UNR-Aerospace-Club/T.A.C.O.S/README.md

# T.A.C.O.S
Typical Avionics Control and Operations System

The hardware and software needed for a custom hat-based modular rocket avionics system
