UNR-Aerospace-Club/T.A.C.O.S/cad/Rack.FCStd

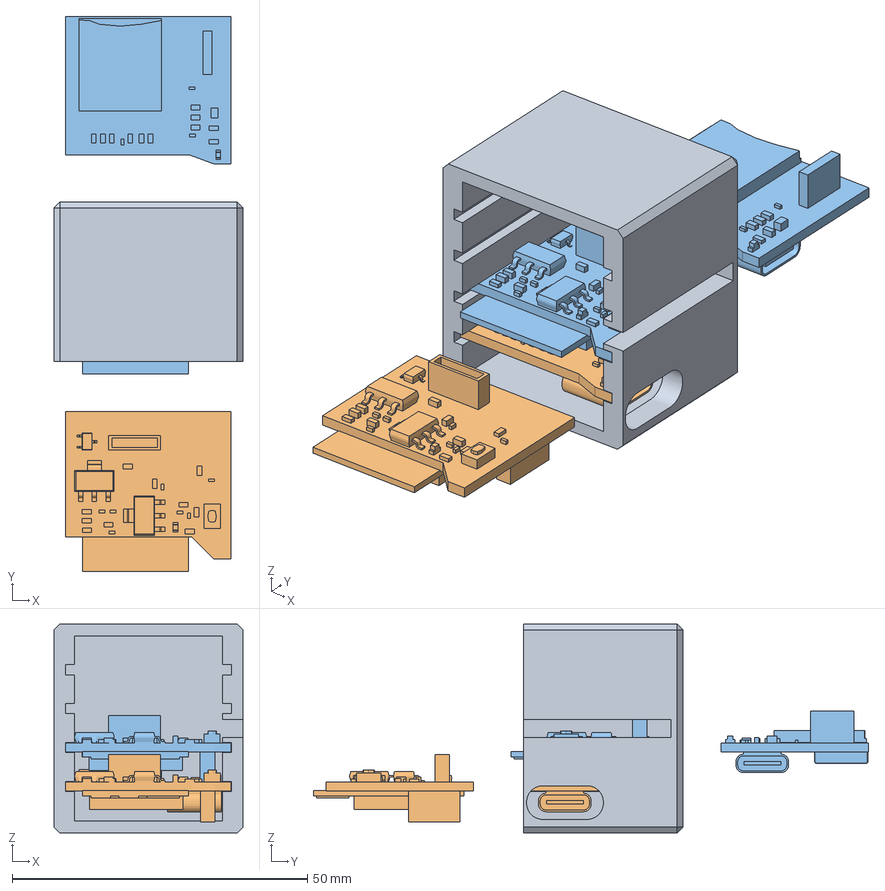
[picture p1: CAD file, 2025-10-07]
cad/Rack.FCStd
32.0 x 94.0 x 35.4 mm
Rack
MainBoardRemesh
MainBoardRemesh001
