UNR-Aerospace-Club/T.A.C.O.S/hardware/DummyHat/DummyHat.kicad_pcb

## KiCad design hardware/DummyHat/DummyHat.kicad_pcb (2025-11-24)

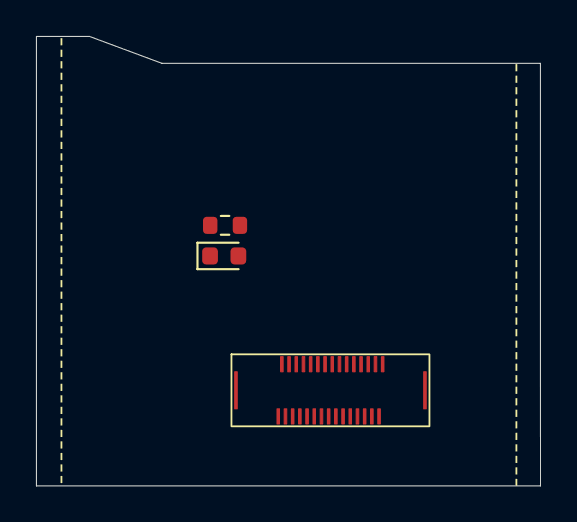
[picture p2: board hardware/DummyHat/DummyHat.kicad_pcb from above]

Board: 2 copper layers, 28.0 x 25.0 mm, 4 parts (1 on the bottom side), 33 nets, no tracks yet.

Parts:
D1: LED; LED_0603_1608Metric
J1, J2: Conn_02x16_Top_Bottom; FSB5 Series 0.40 mm Pitch Floating SlimStack Board-to-Board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
R1: R; R_0603_1608Metric

Connections:
CONN_0: D1.2 (A), J1.1, J2.16
CONN_1: J1.2, J2.17
CONN_2: J1.3, J2.18
CONN_3: J1.4, J2.19
CONN_4: J1.5, J2.20
CONN_5: J1.6, J2.21
CONN_6: J1.7, J2.22
CONN_7: J1.8, J2.23
CONN_8: J1.9, J2.24
CONN_9: J1.10, J2.25
CONN_10: J1.11, J2.26
CONN_11: J1.12, J2.27
CONN_12: J1.13, J2.28
CONN_13: J1.14, J2.29
CONN_14: J1.15, J2.30
CONN_15: J1.16, J2.1
CONN_16: J1.17, J2.2
CONN_17: J1.18, J2.3
CONN_18: J1.19, J2.4
CONN_19: J1.20, J2.5
CONN_20: J1.21, J2.6
CONN_21: J1.22, J2.7
CONN_22: J1.23, J2.8
CONN_23: J1.24, J2.9
CONN_24: J1.25, J2.10
CONN_25: J1.26, J2.11
CONN_26: J1.27, J2.12
CONN_27: J1.28, J2.13
CONN_28: J1.29, J2.14
CONN_29: J1.30, J2.15
GND: J1.32, J2.32, R1.1
unnamed: D1.1 (K), R1.2
VIN: J1.31, J2.31
