UNR-Aerospace-Club/T.A.C.O.S/hardware/MainBoard/MainBoard.kicad_pcb

## KiCad design hardware/MainBoard/MainBoard.kicad_pcb (2025-11-24)

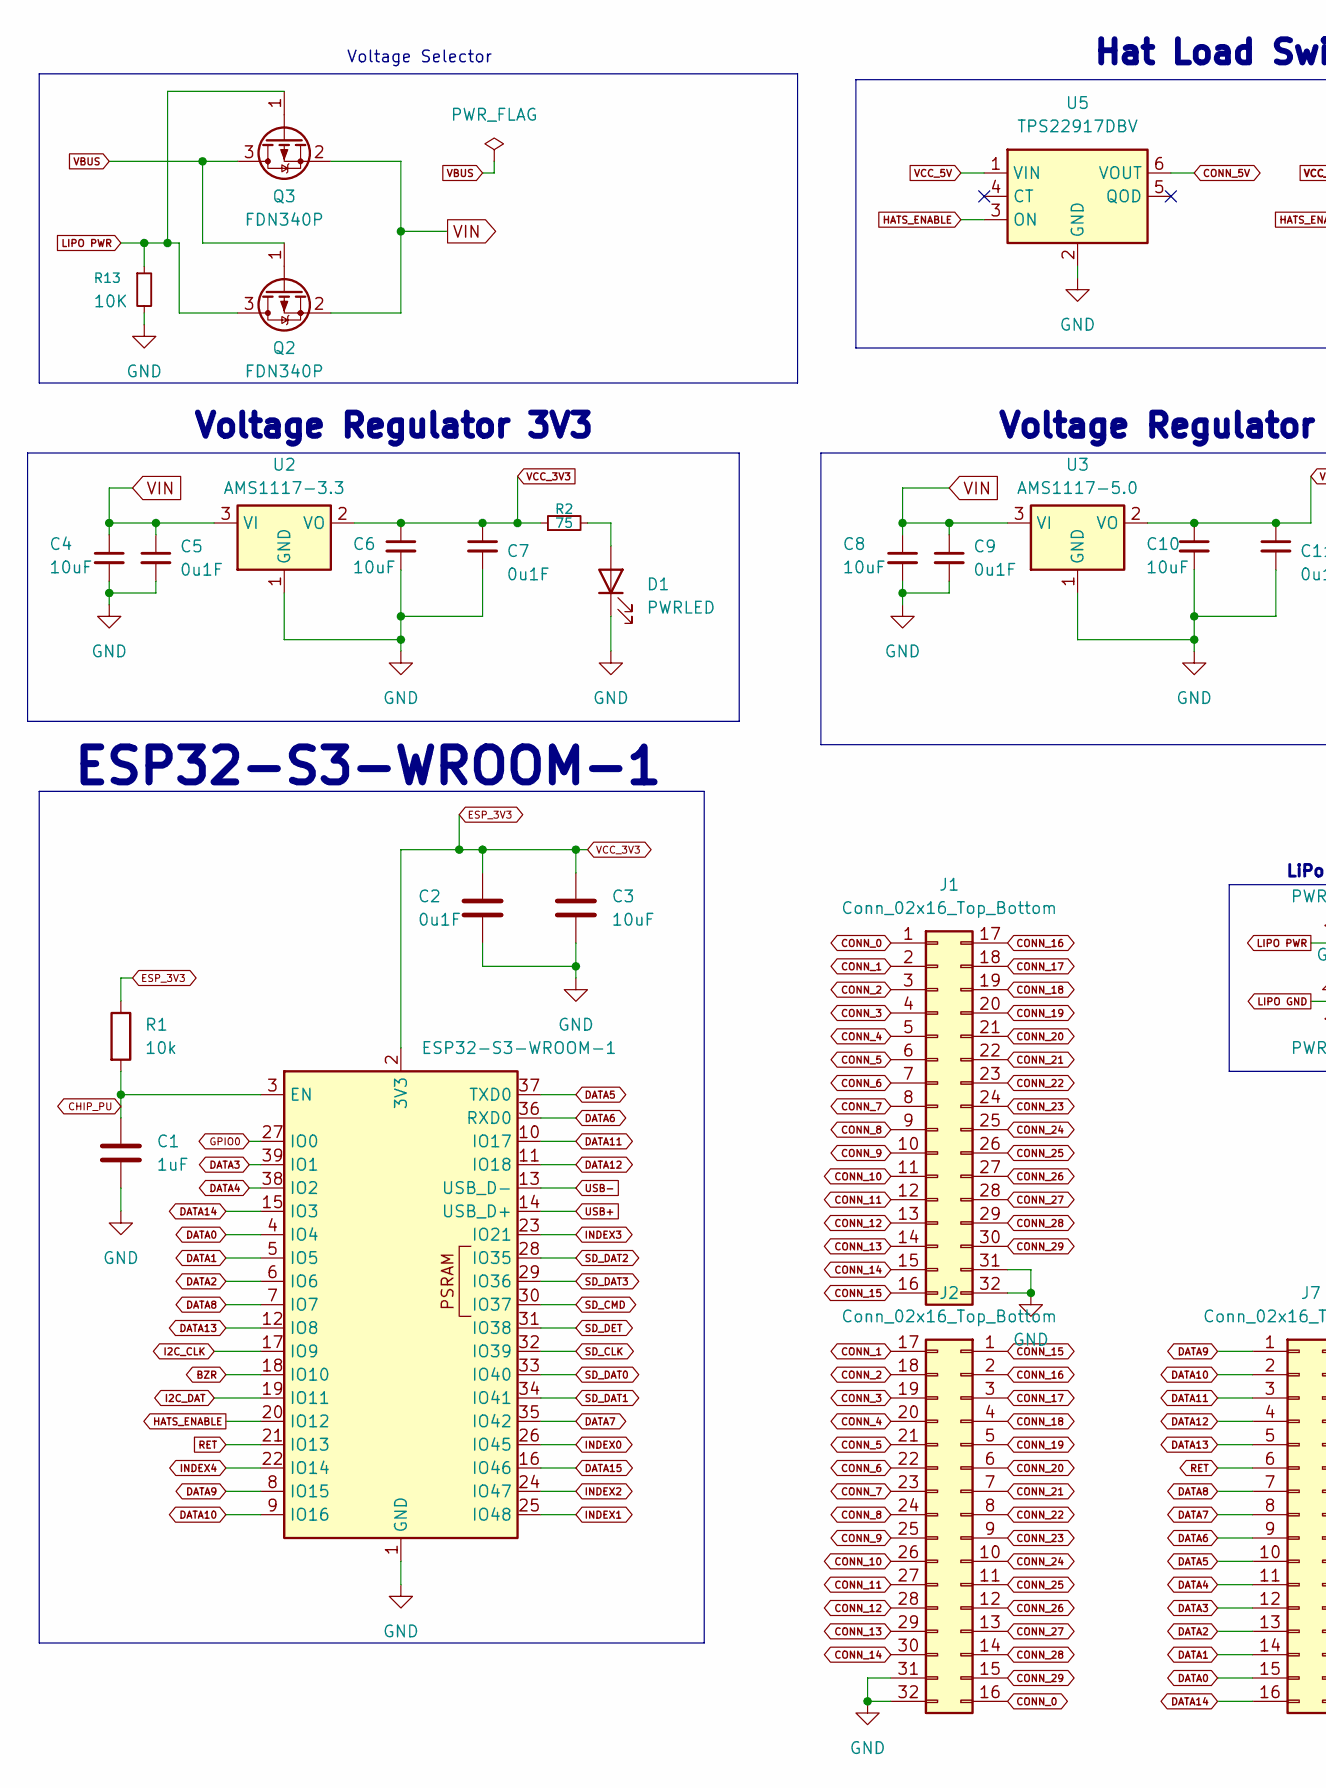
[picture p3: schematic MainBoard.kicad_sch, T.A.C.O.S, part in row 1, column 1]

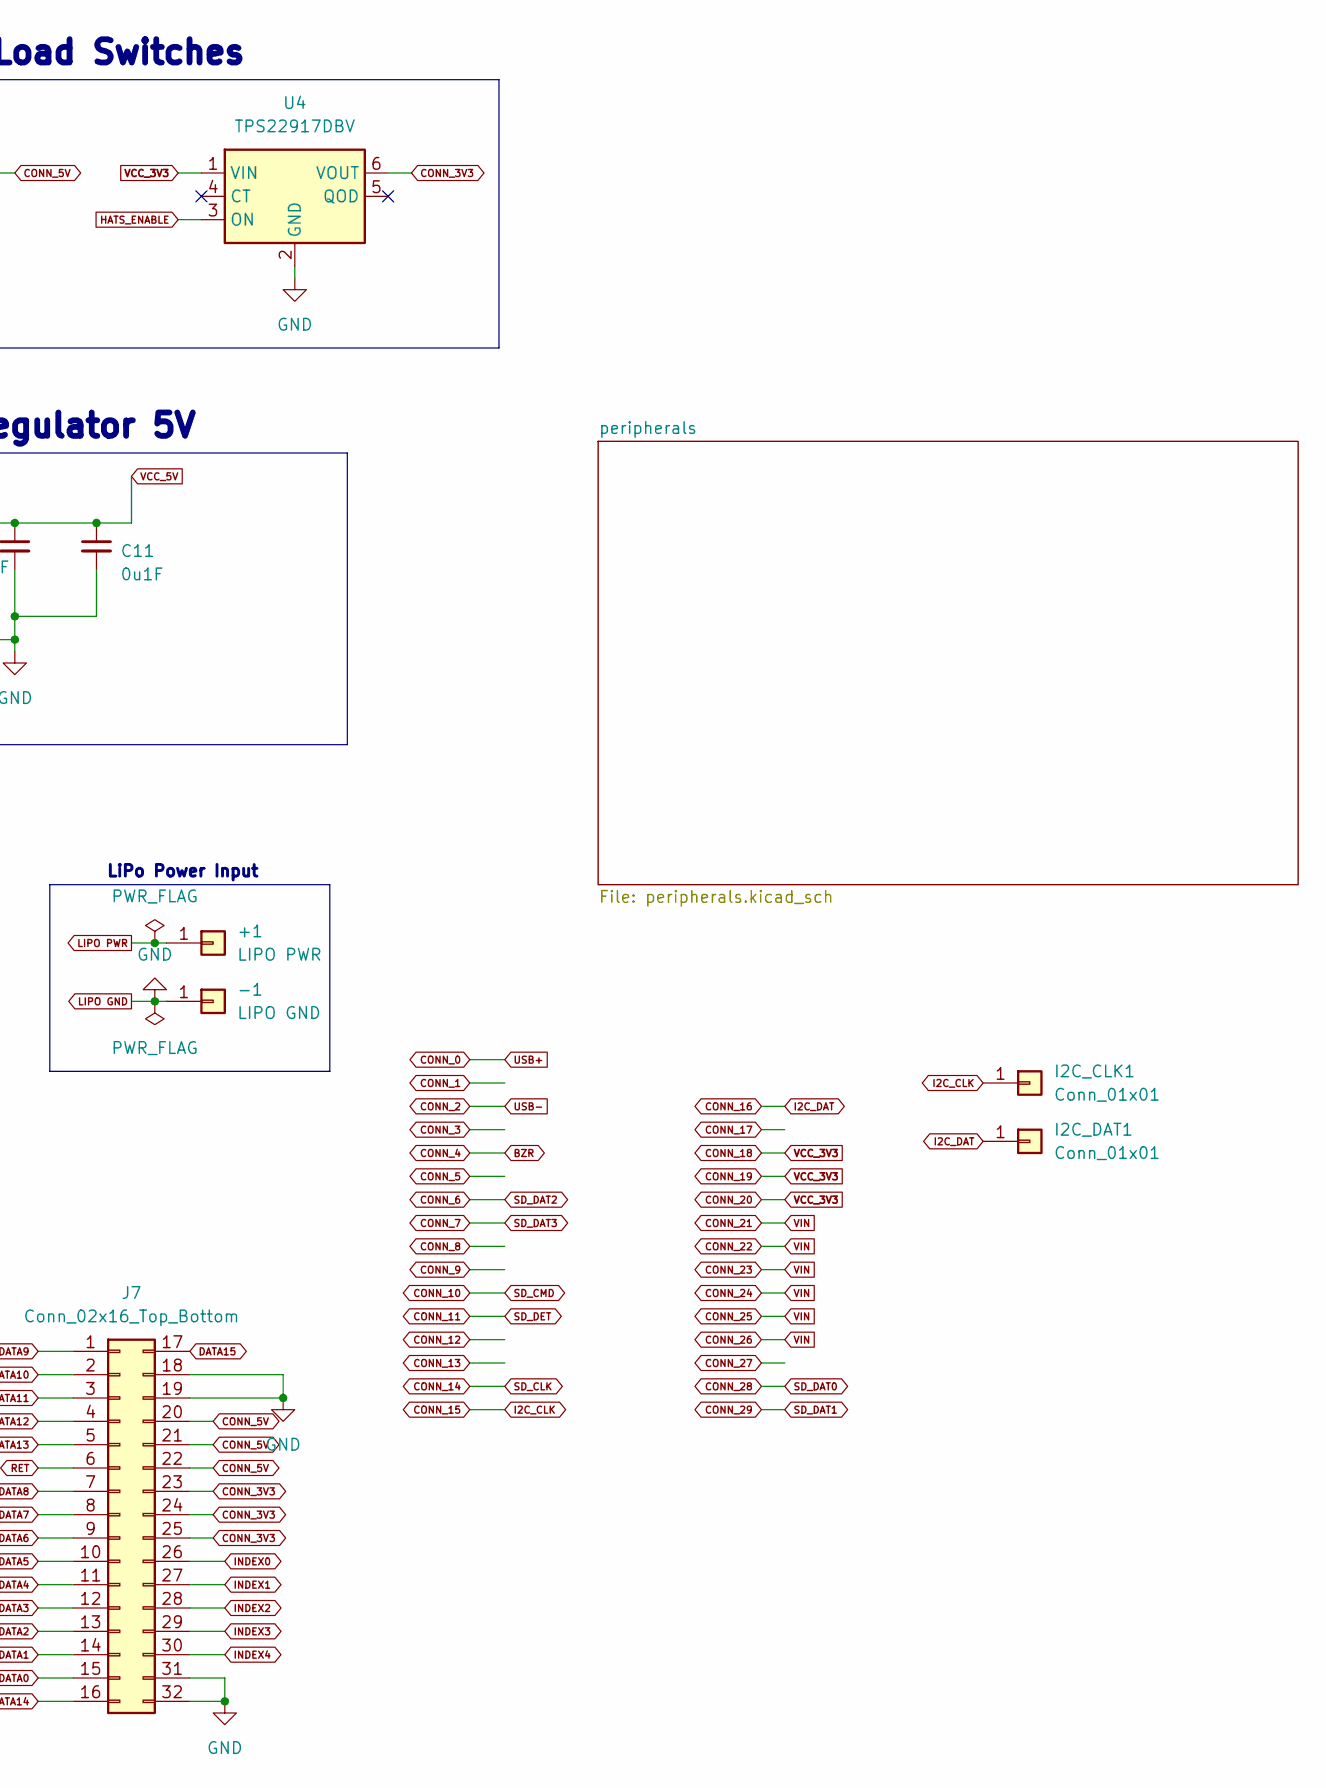
[picture p4: schematic MainBoard.kicad_sch, T.A.C.O.S, part in row 1, column 2]

Parts:
+1: LIPO PWR; TestPoint_Pad_2.0x2.0mm
-1: LIPO GND; TestPoint_Pad_2.0x2.0mm
C1: 1uF; C_0603_1608Metric
C2, C5, C7, C9, C11: 0u1F; C_0402_1005Metric
C3, C4, C6, C8, C10: 10uF; C_0603_1608Metric
D1: PWRLED; LED_0603_1608Metric
I2C_CLK1, I2C_DAT1: Conn_01x01; TestPoint_Pad_1.0x1.0mm
J1, J2, J7: Conn_02x16_Top_Bottom; FSB5 Series 0.40 mm Pitch Floating SlimStack Board-to-Board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
Q2, Q3: FDN340P; SOT-23
R1: 10k; R_0603_1608Metric
R2: 75; R_0603_1608Metric
R13: 10K; R_0603_1608Metric
U1: ESP32-S3-WROOM-1; ESP32-S3-WROOM-1U
U2: AMS1117-3.3; SOT-223-3_TabPin2
U3: AMS1117-5.0; SOT-223-3_TabPin2
U4, U5: TPS22917DBV; SOT-23-6

Connections:
BZR: J1.5, J2.20, U1.18 (IO10); also elsewhere on the board
CHIP_PU: C1.1, R1.2, U1.3 (EN); also elsewhere on the board
CONN_0: J1.1, J2.16, U1.14 (USB_D+); also elsewhere on the board
CONN_1: J1.2, J2.17
CONN_2: J1.3, J2.18, U1.13 (USB_D-); also elsewhere on the board
CONN_3: J1.4, J2.19
CONN_3V3: J7.23, J7.24, J7.25, U4.6 (VOUT)
CONN_5: J1.6, J2.21
CONN_5V: J7.20, J7.21, J7.22, U5.6 (VOUT)
CONN_6: J1.7, J2.22, U1.28 (IO35); also elsewhere on the board
CONN_7: J1.8, J2.23, U1.29 (IO36); also elsewhere on the board
CONN_8: J1.9, J2.24
CONN_9: J1.10, J2.25
CONN_10: J1.11, J2.26, U1.30 (IO37); also elsewhere on the board
CONN_11: J1.12, J2.27, U1.31 (IO38); also elsewhere on the board
CONN_12: J1.13, J2.28
CONN_13: J1.14, J2.29
CONN_14: J1.15, J2.30, U1.32 (IO39); also elsewhere on the board
CONN_15: I2C_CLK1.1, J1.16, J2.1, U1.17 (IO9)
CONN_16: I2C_DAT1.1, J1.17, J2.2, U1.19 (IO11)
CONN_17: J1.18, J2.3
CONN_18: C2.1, C3.1, C6.1, C7.1, J1.19, J1.20, J1.21, J2.4, J2.5, J2.6, R1.1, R2.1, U1.2 (3V3), U2.2 (VO), U4.1 (VIN); also elsewhere on the board
CONN_21: C4.1, C5.1, C8.1, C9.1, J1.22, J1.23, J1.24, J1.25, J1.26, J1.27, J2.7, J2.8, J2.9, J2.10, J2.11, J2.12, Q2.2 (S), Q3.2 (S), U2.3 (VI), U3.3 (VI)
CONN_27: J1.28, J2.13
CONN_28: J1.29, J2.14, U1.33 (IO40); also elsewhere on the board
CONN_29: J1.30, J2.15, U1.34 (IO41); also elsewhere on the board
DATA0: J7.15, U1.4 (IO4)
DATA1: J7.14, U1.5 (IO5)
DATA2: J7.13, U1.6 (IO6)
DATA3: J7.12, U1.39 (IO1)
DATA4: J7.11, U1.38 (IO2)
DATA5: J7.10, U1.37 (TXD0)
DATA6: J7.9, U1.36 (RXD0)
DATA7: J7.8, U1.35 (IO42)
DATA8: J7.7, U1.7 (IO7)
DATA9: J7.1, U1.8 (IO15)
DATA10: J7.2, U1.9 (IO16)
DATA11: J7.3, U1.10 (IO17)
DATA12: J7.4, U1.11 (IO18)
DATA13: J7.5, U1.12 (IO8)
DATA14: J7.16, U1.15 (IO3)
DATA15: J7.17, U1.16 (IO46)
GPIO0: U1.27 (IO0); also elsewhere on the board
HATS_ENABLE: U1.20 (IO12), U4.3 (ON), U5.3 (ON)
INDEX0: J7.26, U1.26 (IO45)
INDEX1: J7.27, U1.25 (IO48)
INDEX2: J7.28, U1.24 (IO47)
INDEX3: J7.29, U1.23 (IO21)
INDEX4: J7.30, U1.22 (IO14)
LIPO GND: -1.1, C1.2, C2.2, C3.2, C4.2, C5.2, C6.2, C7.2, C8.2, C9.2, C10.2, C11.2, D1.1 (K), J1.31, J1.32, J2.31, J2.32, J7.18, J7.19, J7.31, J7.32, R13.2, U1.1 (GND), U1.40 (GND), U1.41 (GND), U2.1 (GND), U3.1 (GND), U4.2 (GND), U5.2 (GND); also elsewhere on the board
LIPO PWR: +1.1, Q2.3 (D), Q3.1 (G), R13.1
unnamed: D1.2 (A), R2.2
RET: J7.6, U1.21 (IO13)
VBUS: Q2.1 (G), Q3.3 (D); also elsewhere on the board
VCC_5V: C10.1, C11.1, U3.2 (VO), U5.1 (VIN)

Notes on the sheet:
Voltage Regulator 5V
ESP32-S3-WROOM-1
Voltage Regulator 3V3
Voltage Selector
LiPo Power Input
Hat Load Switches

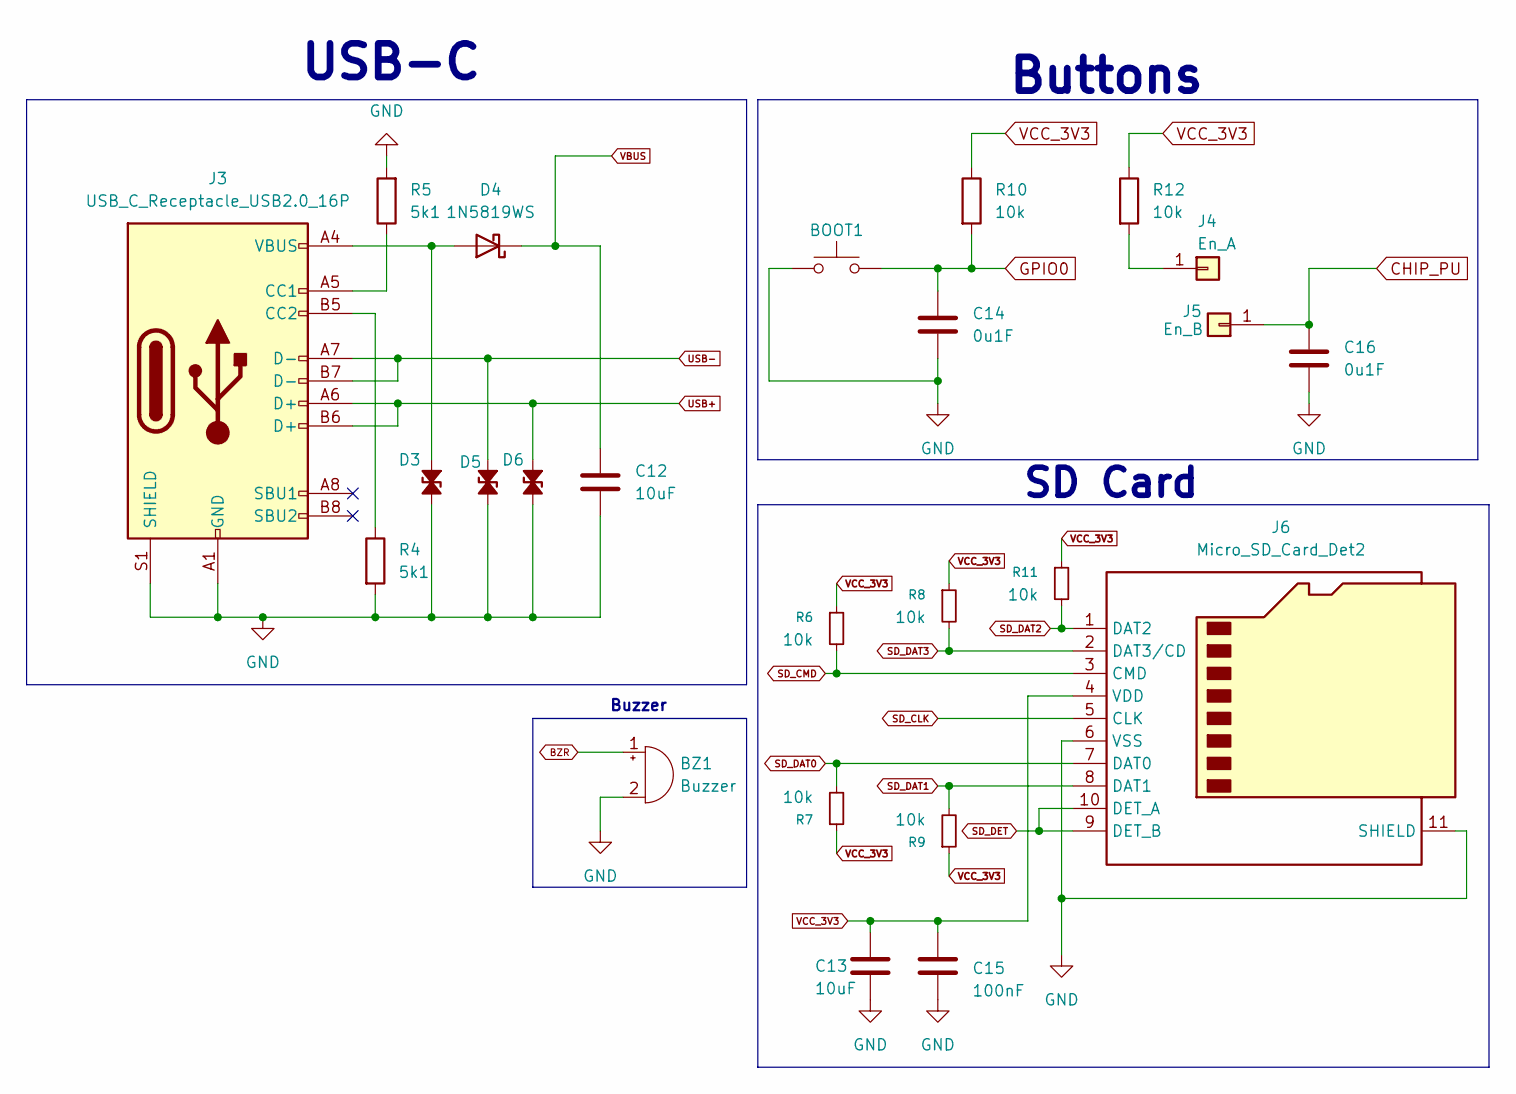
[picture p5: schematic peripherals.kicad_sch]

Parts:
BOOT1: RESET; SW_Push_1P1T_NO_CK_KMR2
BZ1: Buzzer; Buzzer_Murata_PKMCS0909E
C12, C13: 10uF; C_0603_1608Metric
C14, C16: 0u1F; C_0402_1005Metric
C15: 100nF; C_0402_1005Metric
D3, D5, D6: D_TVS_Small_Filled; D_0603_1608Metric
D4: 1N5819WS; D_SOD-323
J3: USB_C_Receptacle_USB2.0_16P; USB_C_Receptacle_GCT_USB4085
J4: En_A; TestPoint_Pad_1.5x1.5mm
J5: En_B; TestPoint_Pad_1.5x1.5mm
J6: Micro_SD_Card_Det2; microSD_HC_Hirose_DM3AT-SF-PEJM5
R4, R5: 5k1; R_0402_1005Metric
R6, R7, R8, R9, R10, R11, R12: 10k; R_0603_1608Metric

Connections:
BZR: BZ1.1 (+); also elsewhere on the board
CHIP_PU: C16.1, J5.1; also elsewhere on the board
CONN_0: D6.1 (A1), J3.A6 (D+), J3.B6 (D+); also elsewhere on the board
CONN_2: D5.1 (A1), J3.A7 (D-), J3.B7 (D-); also elsewhere on the board
CONN_6: J6.1 (DAT2), R11.2; also elsewhere on the board
CONN_7: J6.2 (DAT3/CD), R8.2; also elsewhere on the board
CONN_10: J6.3 (CMD), R6.2; also elsewhere on the board
CONN_11: J6.9 (DET_B), J6.10 (DET_A); also elsewhere on the board
CONN_14: J6.5 (CLK); also elsewhere on the board
CONN_18: C13.1, C15.1, J6.4 (VDD), R6.1, R7.1, R8.1, R9.1, R10.1, R11.1, R12.1; also elsewhere on the board
CONN_28: J6.7 (DAT0), R7.2; also elsewhere on the board
CONN_29: J6.8 (DAT1), R9.2; also elsewhere on the board
GPIO0: BOOT1.2, C14.1, R10.2; also elsewhere on the board
LIPO GND: BOOT1.1, BZ1.2 (-), C12.2, C13.2, C14.2, C15.2, C16.2, D3.2 (A2), D5.2 (A2), D6.2 (A2), J3.A1 (GND), J3.A12 (GND), J3.B1 (GND), J3.B12 (GND), J3.S1 (SHIELD), J6.6 (VSS), J6.11 (SHIELD), R4.2, R5.2; also elsewhere on the board
unnamed: D3.1 (A1), D4.2 (A), J3.A4 (VBUS), J3.A9 (VBUS), J3.B4 (VBUS), J3.B9 (VBUS)
unnamed: J3.A5 (CC1), R5.1
unnamed: J3.B5 (CC2), R4.1
unnamed: J4.1, R12.2
VBUS: C12.1, D4.1 (K); also elsewhere on the board

Notes on the sheet:
USB-C
Buzzer
SD Card
Buttons

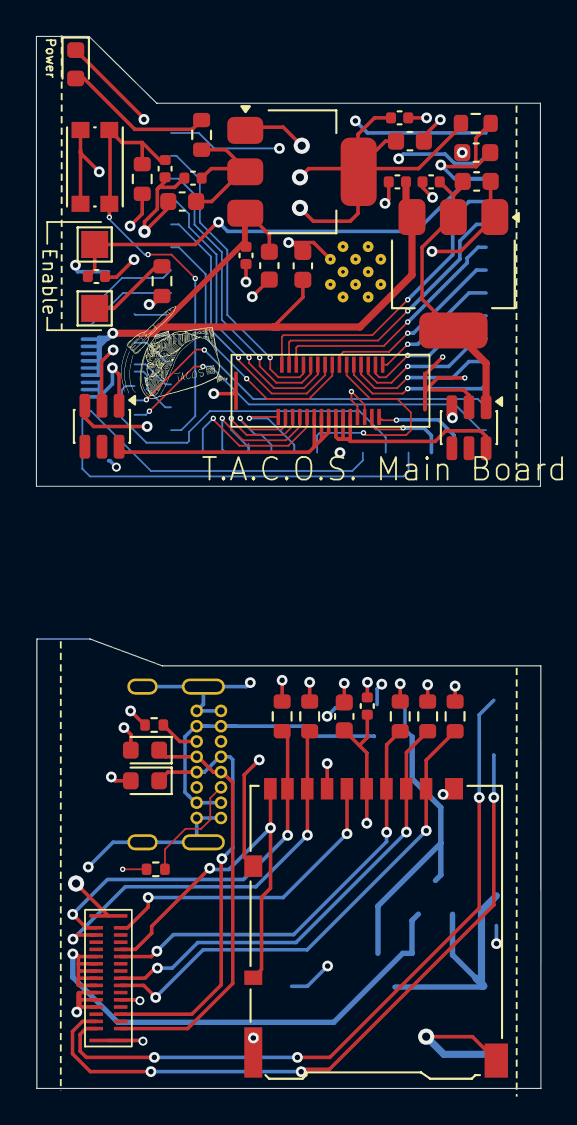
[picture p6: board hardware/MainBoard/MainBoard.kicad_pcb from above]

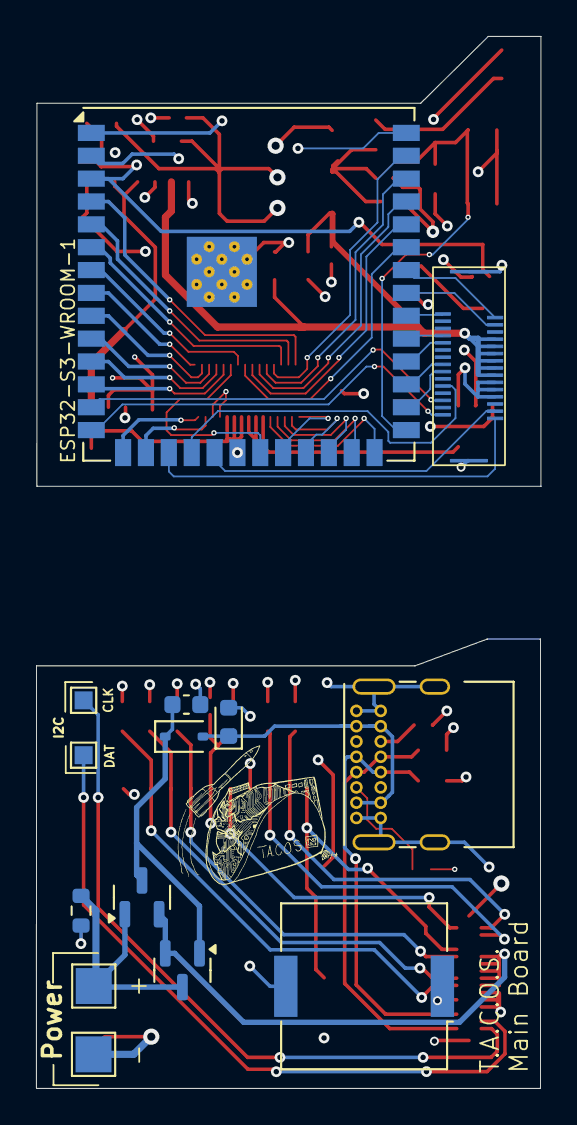
[picture p7: board hardware/MainBoard/MainBoard.kicad_pcb from below]

Board: 4 copper layers, 28.0 x 58.4 mm, 53 parts (14 on the bottom side), 59 nets.
