UNR-Aerospace-Club/T.A.C.O.S/hardware/RocketHat/RocketHat.kicad_pcb

## KiCad design hardware/RocketHat/RocketHat.kicad_pcb (2025-11-23)

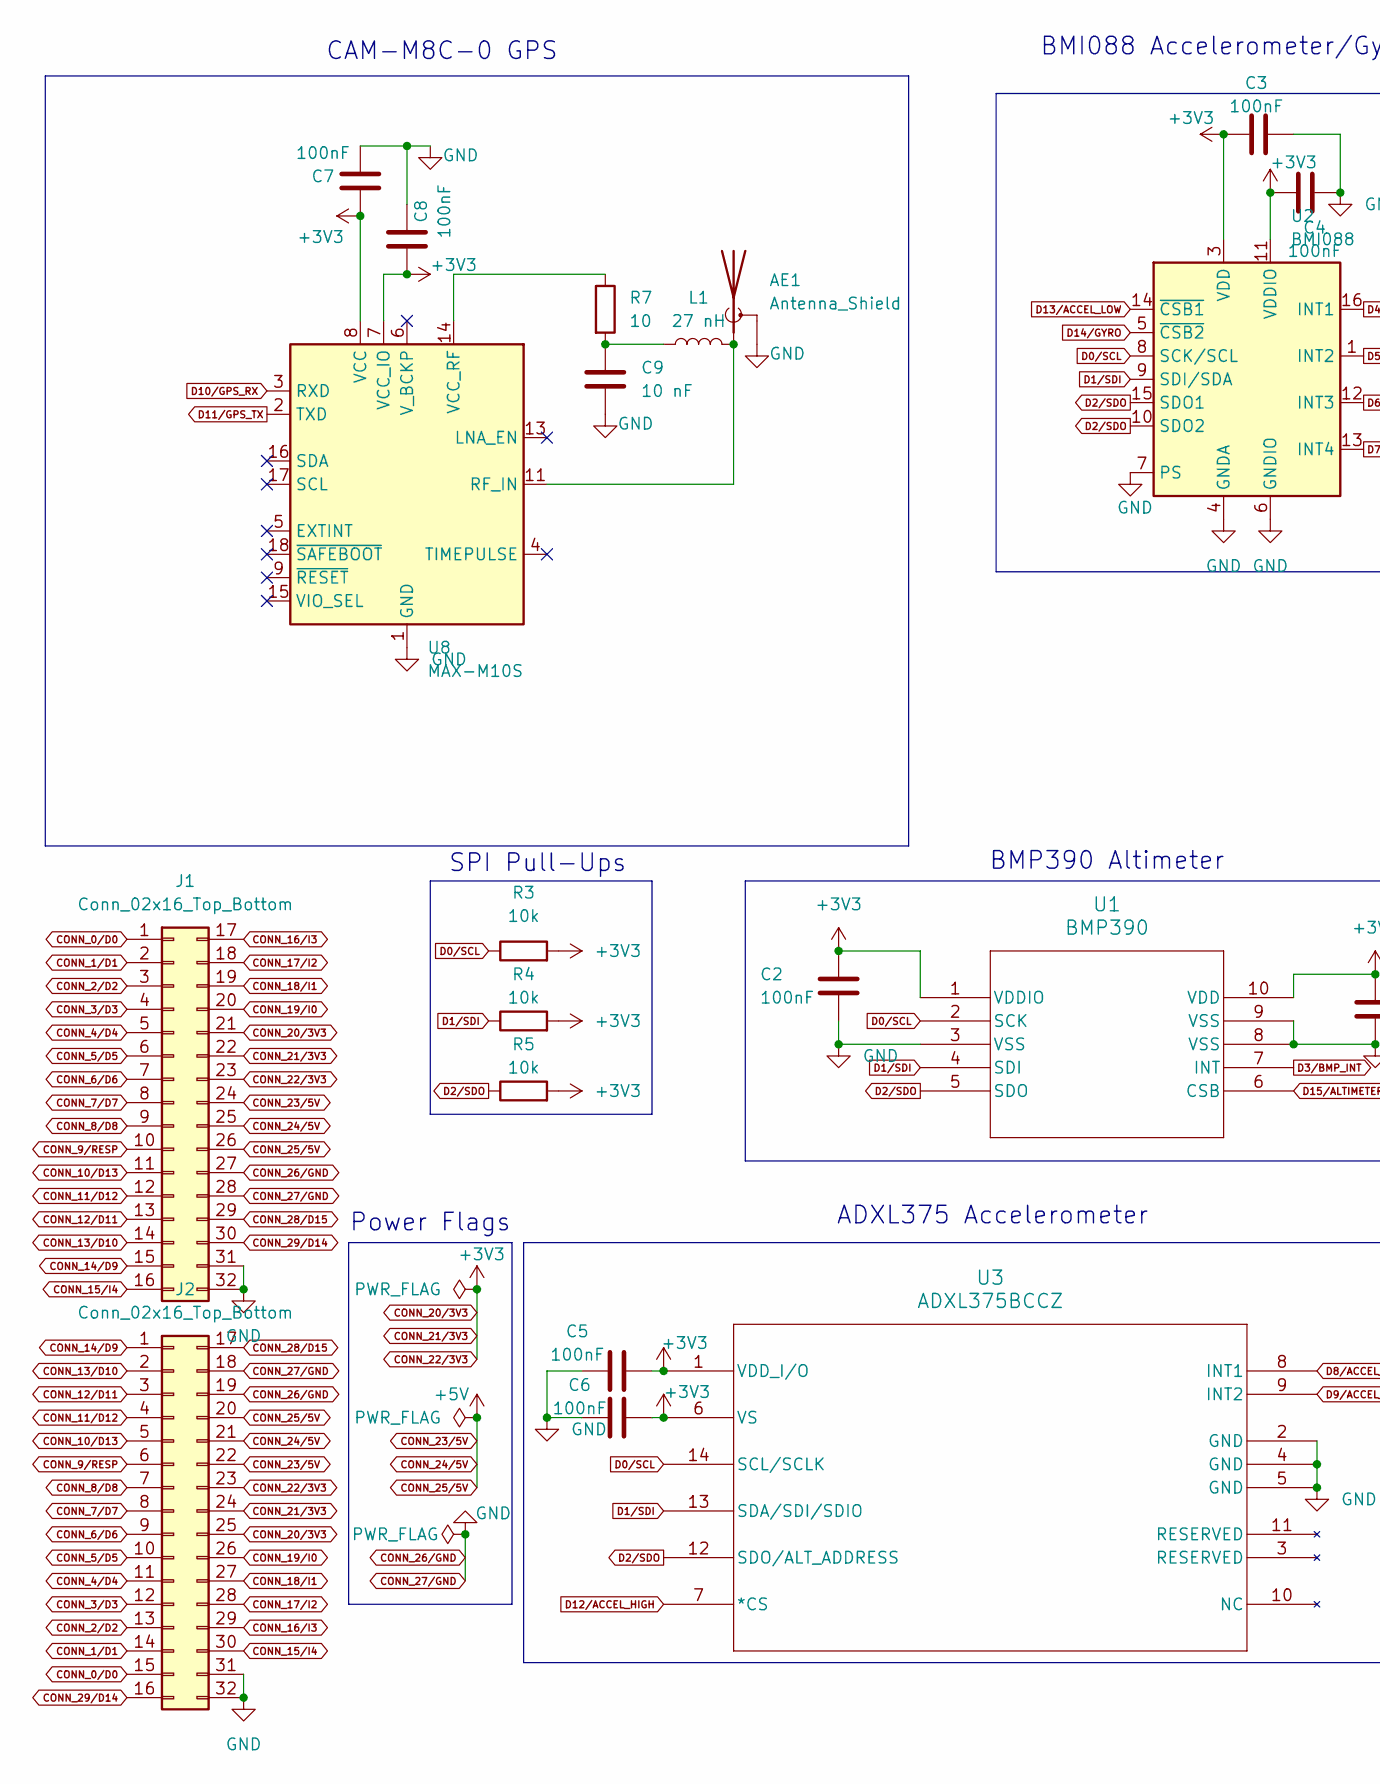
[picture p8: schematic RocketHat.kicad_sch, T.A.C.O.S Rocket Hat, part in row 1, column 1]

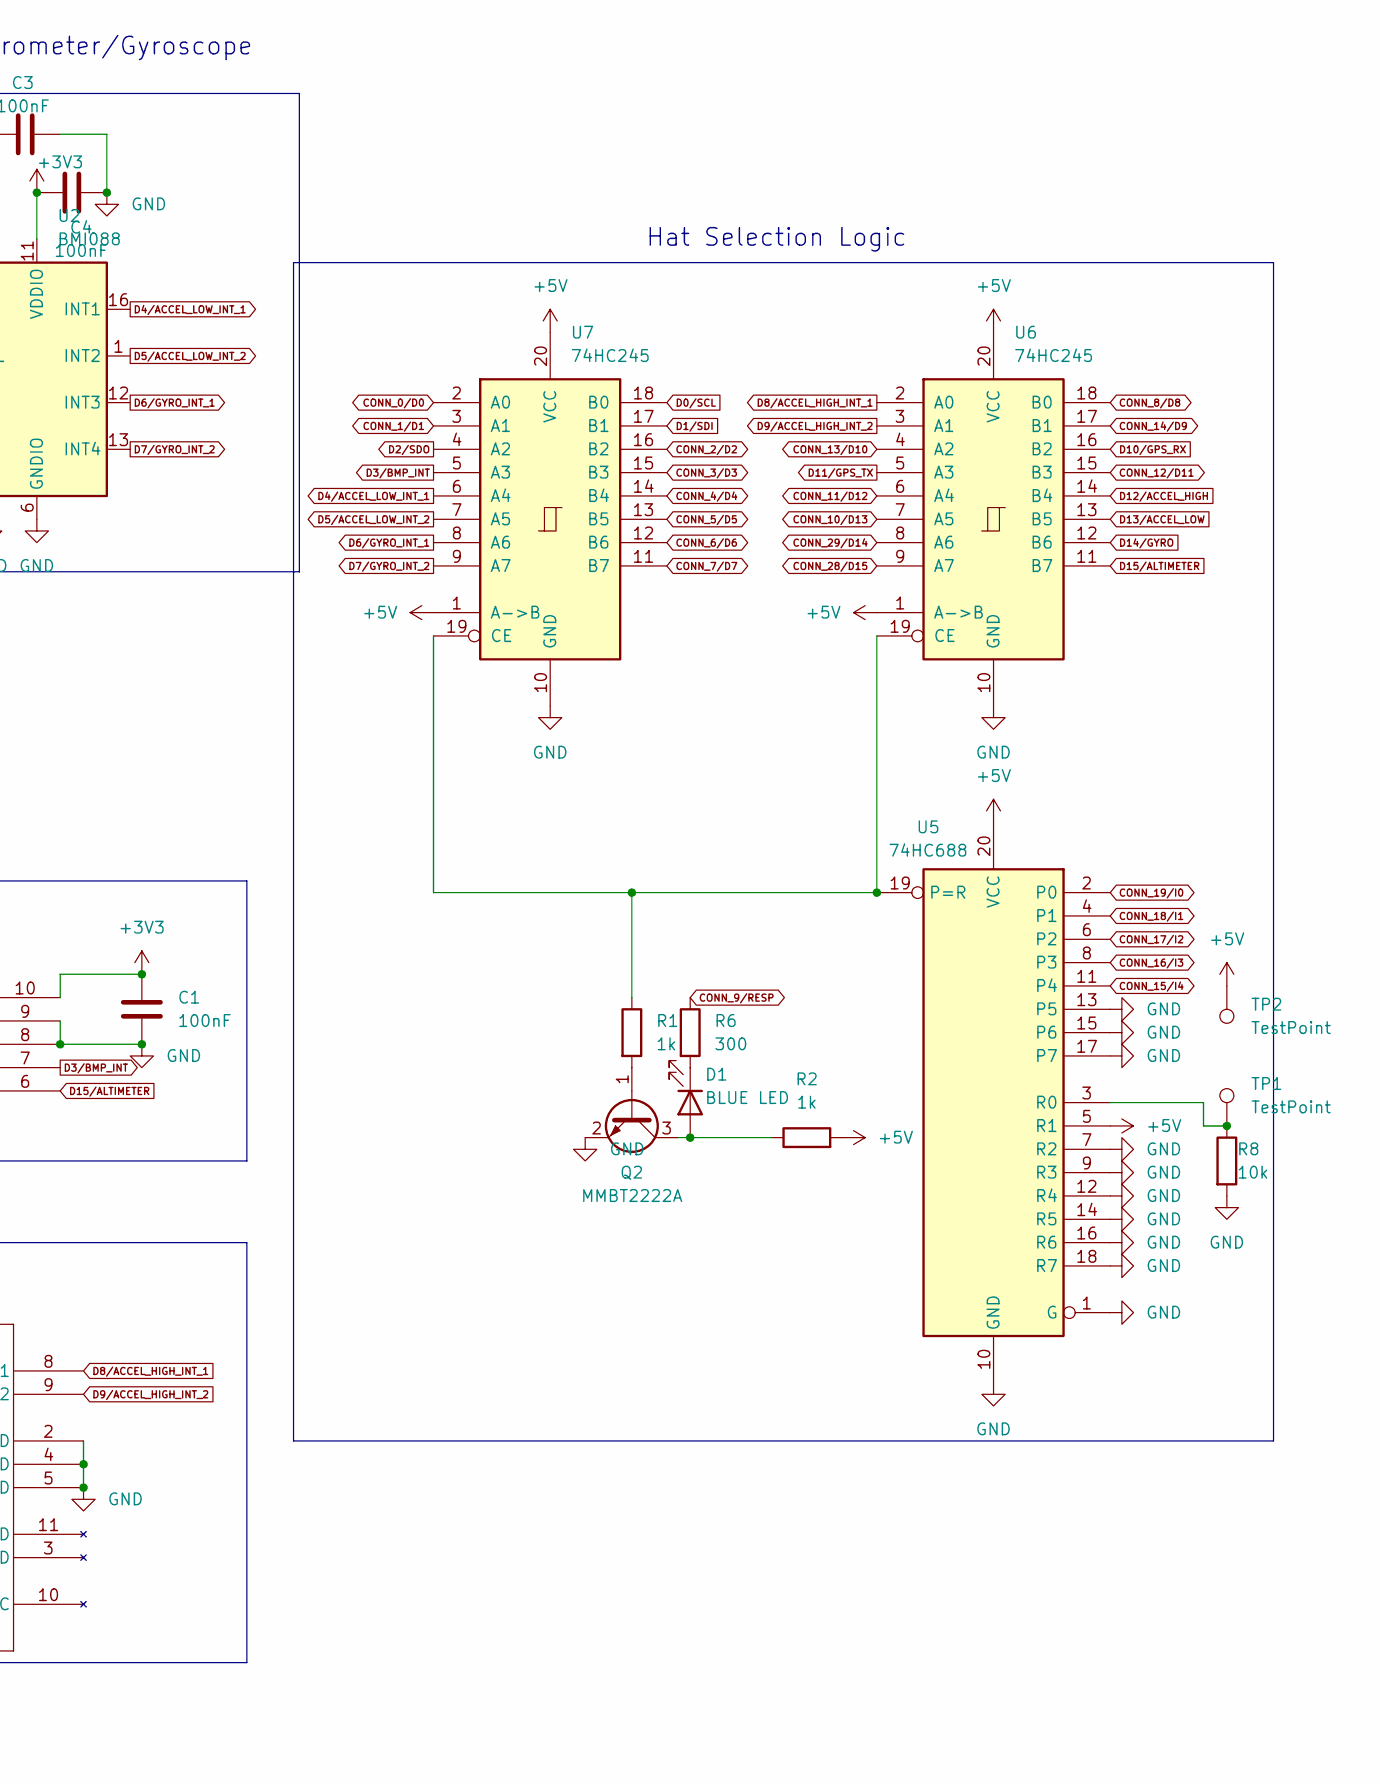
[picture p9: schematic RocketHat.kicad_sch, T.A.C.O.S Rocket Hat, part in row 1, column 2]

Parts:
AE1: Antenna_Shield; U.FL_Molex_MCRF_73412-0110_Vertical
C1, C2, C3, C4, C5, C6, C7, C8: 100nF; C_0201_0603Metric
C9: 10 nF; C_0201_0603Metric
D1: BLUE LED; LED_0201_0603Metric
J1, J2: Conn_02x16_Top_Bottom; FSB5 Series 0.40 mm Pitch Floating SlimStack Board-to-Board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
L1: 27 nH; L_0201_0603Metric
Q2: MMBT2222A; SOT-23
R1, R2: 1k; R_0201_0603Metric
R3, R4, R5, R8: 10k; R_0201_0603Metric
R6: 300; R_0201_0603Metric
R7: 10; R_0201_0603Metric
TP1, TP2: TestPoint; TestPoint_Pad_1.5x1.5mm
U1: BMP390; 10LGA_2X2X0p75_BOS
U2: BMI088; Bosch_LGA-16_4.5x3mm_P0.5mm_LayoutBorder7x1y_ClockwisePinNu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
U3: ADXL375BCCZ; LGA_CC-14-1_ADI
U5: 74HC688; TSSOP-20_4.4x6.5mm_P0.65mm
U6, U7: 74HC245; DHVQFN-20-1EP_2.5x4.5mm_P0.5mm_EP1x3mm
U8: MAX-M10S; ublox_MAX

Connections:
CONN_0/D0: J1.1, J2.15, U7.2 (A0)
CONN_1/D1: J1.2, J2.14, U7.3 (A1)
CONN_2/D2: J1.3, J2.13, U7.16 (B2)
CONN_3/D3: J1.4, J2.12, U7.15 (B3)
CONN_4/D4: J1.5, J2.11, U7.14 (B4)
CONN_5/D5: J1.6, J2.10, U7.13 (B5)
CONN_6/D6: J1.7, J2.9, U7.12 (B6)
CONN_7/D7: J1.8, J2.8, U7.11 (B7)
CONN_8/D8: J1.9, J2.7, U6.18 (B0)
CONN_9/RESP: J1.10, J2.6, R6.1
CONN_10/D13: J1.11, J2.5, U6.7 (A5)
CONN_11/D12: J1.12, J2.4, U6.6 (A4)
CONN_12/D11: J1.13, J2.3, U6.15 (B3)
CONN_13/D10: J1.14, J2.2, U6.4 (A2)
CONN_14/D9: J1.15, J2.1, U6.17 (B1)
CONN_15/I4: J1.16, J2.30, U5.11 (P4)
CONN_16/I3: J1.17, J2.29, U5.8 (P3)
CONN_17/I2: J1.18, J2.28, U5.6 (P2)
CONN_18/I1: J1.19, J2.27, U5.4 (P1)
CONN_19/I0: J1.20, J2.26, U5.2 (P0)
CONN_20/3V3: C1.1, C2.1, C3.2, C4.2, C5.1, C6.1, C7.2, C8.2, J1.21, J1.22, J1.23, J2.23, J2.24, J2.25, R3.2, R4.2, R5.2, U1.1 (VDDIO), U1.10 (VDD), U2.3 (VDD), U2.11 (VDDIO), U3.1 (VDD_I/O), U3.6 (VS), U8.7 (VCC_IO), U8.8 (VCC)
CONN_23/5V: J1.24, J1.25, J1.26, J2.20, J2.21, J2.22, R2.2, TP2.1, U5.5 (R1), U5.20 (VCC), U6.1 (A->B), U6.20 (VCC), U7.1 (A->B), U7.20 (VCC)
CONN_26/GND: AE1.2 (Shield), C1.2, C2.2, C3.1, C4.1, C5.2, C6.2, C7.1, C8.1, C9.2, J1.27, J1.28, J1.31, J1.32, J2.18, J2.19, J2.31, J2.32, Q2.2 (E), R8.2, U1.3 (VSS), U1.8 (VSS), U1.9 (VSS), U2.2 (GNDA), U2.4 (GNDA), U2.6 (GNDIO), U2.7 (PS), U3.2 (GND), U3.4 (GND), U3.5 (GND), U5.1 (G), U5.7 (R2), U5.9 (R3), U5.10 (GND), U5.12 (R4), U5.13 (P5), U5.14 (R5), U5.15 (P6), U5.16 (R6), U5.17 (P7), U5.18 (R7), U6.10 (GND), U6.21, U7.10 (GND), U7.21, U8.1 (GND), U8.10 (GND), U8.12 (GND)
CONN_28/D15: J1.29, J2.17, U6.9 (A7)
CONN_29/D14: J1.30, J2.16, U6.8 (A6)
D0/SCL: R3.1, U1.2 (SCK), U2.8 (SCK/SCL), U3.14 (SCL/SCLK), U7.18 (B0)
D1/SDI: R4.1, U1.4 (SDI), U2.9 (SDI/SDA), U3.13 (SDA/SDI/SDIO), U7.17 (B1)
D2/SDO: R5.1, U1.5 (SDO), U2.10 (SDO2), U2.15 (SDO1), U3.12 (SDO/ALT_ADDRESS), U7.4 (A2)
D3/BMP_INT: U1.7 (INT), U7.5 (A3)
D4/ACCEL_LOW_INT_1: U2.16 (INT1), U7.6 (A4)
D5/ACCEL_LOW_INT_2: U2.1 (INT2), U7.7 (A5)
D6/GYRO_INT_1: U2.12 (INT3), U7.8 (A6)
D7/GYRO_INT_2: U2.13 (INT4), U7.9 (A7)
D8/ACCEL_HIGH_INT_1: U3.8 (INT1), U6.2 (A0)
D9/ACCEL_HIGH_INT_2: U3.9 (INT2), U6.3 (A1)
D10/GPS_RX: U6.16 (B2), U8.3 (RXD)
D11/GPS_TX: U6.5 (A3), U8.2 (TXD)
D12/ACCEL_HIGH: U3.7 (*CS), U6.14 (B4)
D13/ACCEL_LOW: U2.14 (~CSB1), U6.13 (B5)
D14/GYRO: U2.5 (~CSB2), U6.12 (B6)
D15/ALTIMETER: U1.6 (CSB), U6.11 (B7)
unnamed: AE1.1 (A), L1.2, U8.11 (RF_IN)
unnamed: C9.1, L1.1, R7.2
unnamed: D1.2 (A), Q2.3 (C), R2.1
unnamed: D1.1 (K), R6.2
unnamed: Q2.1 (B), R1.2
unnamed: R1.1, U5.19 (P=R), U6.19 (CE), U7.19 (CE)
unnamed: R8.1, TP1.1, U5.3 (R0)
unnamed: R7.1, U8.14 (VCC_RF)

Notes on the sheet:
SPI Pull-Ups
Hat Selection Logic
CAM-M8C-0 GPS
BMP390 Altimeter
Power Flags
ADXL375 Accelerometer
BMI088 Accelerometer/Gyroscope

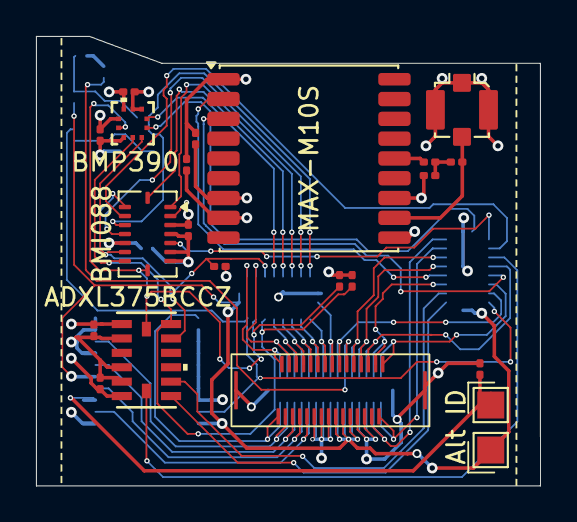
[picture p10: board RocketHat.kicad_pcb from above]

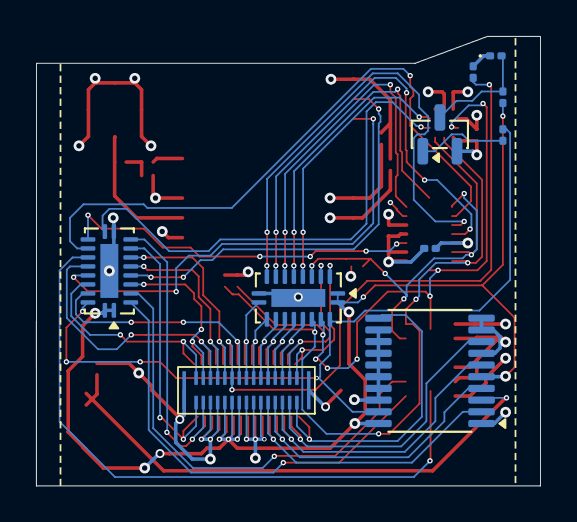
[picture p11: board RocketHat.kicad_pcb from below]

Board: 4 copper layers, 28.0 x 25.0 mm, 32 parts (10 on the bottom side), 49 nets.
