UNR-Aerospace-Club/T.A.C.O.S/hardware/Test_Boards/MainBoard 1layer/MainBoard.kicad_pcb

## KiCad design hardware/Test_Boards/MainBoard 1layer/MainBoard.kicad_pcb (2025-10-02)

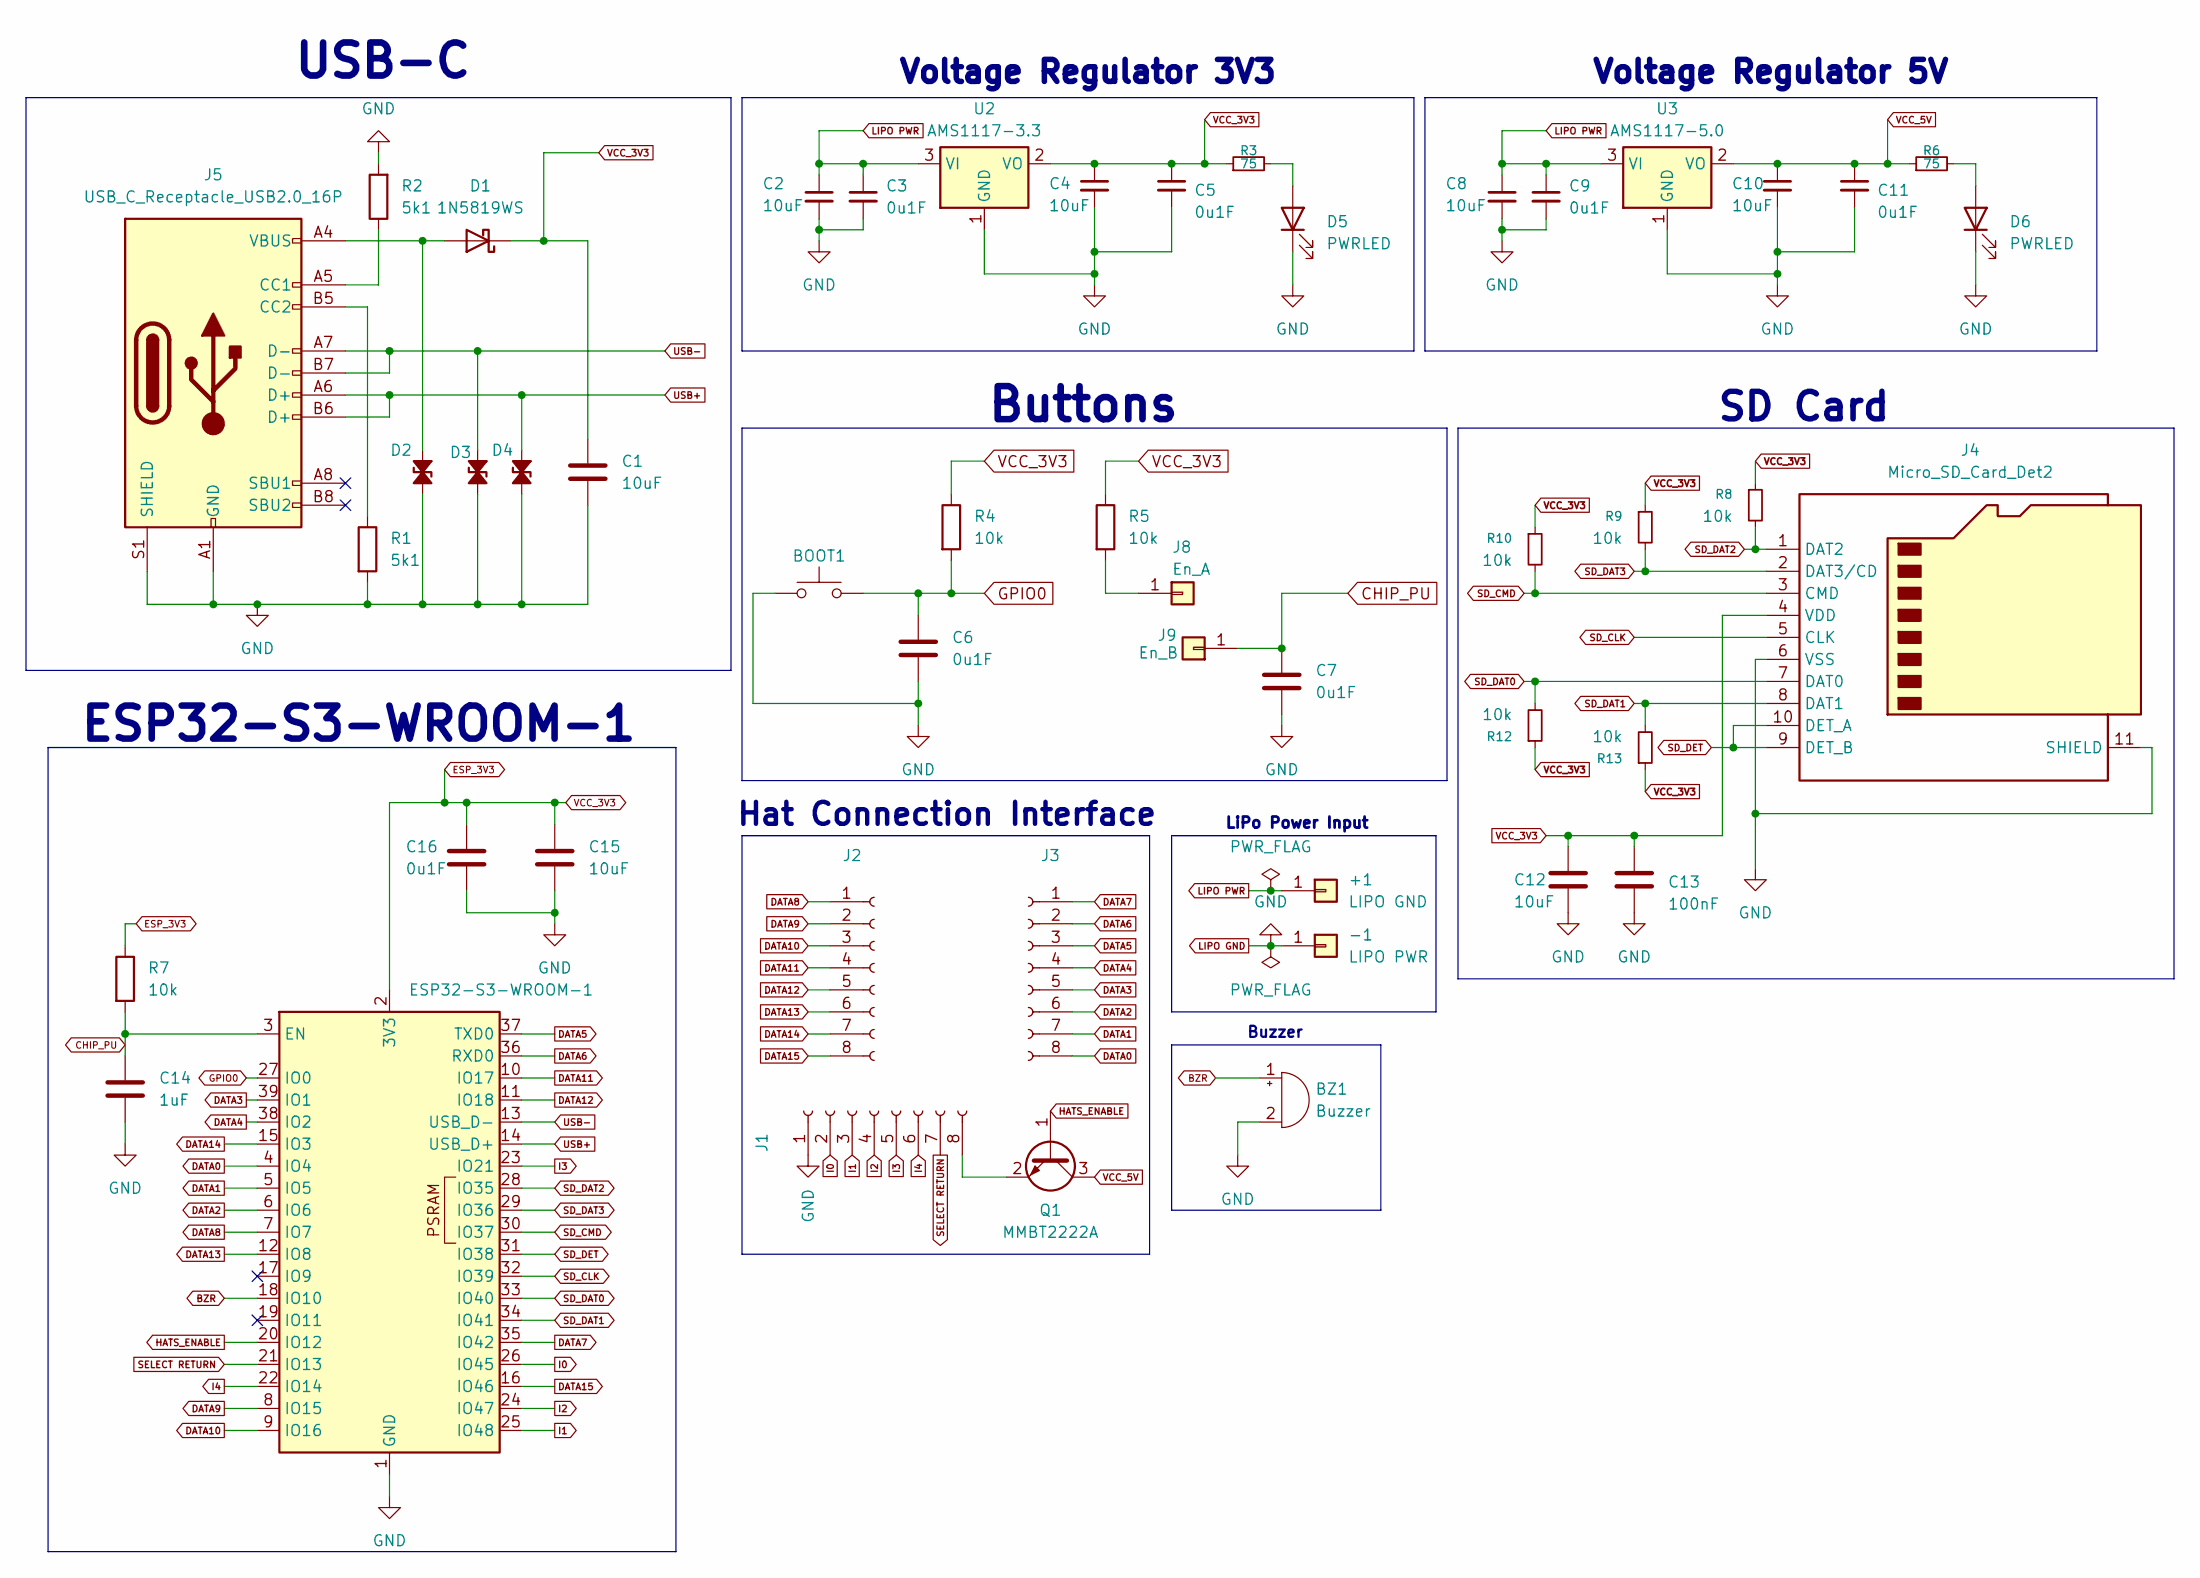
[picture p12: schematic MainBoard.kicad_sch, T.A.C.O.S]

Parts:
+1: LIPO GND; TestPoint_Pad_4.0x4.0mm
-1: LIPO PWR; TestPoint_Pad_4.0x4.0mm
BOOT1: RESET; SW_Push_1P1T_NO_CK_KMR2
BZ1: Buzzer; MagneticBuzzer_Kingstate_KCG0601
C1, C2, C4, C8, C10, C12, C15: 10uF; C_0805_2012Metric
C3, C5, C6, C7, C9, C11, C16: 0u1F; C_0402_1005Metric
C13: 100nF; C_0402_1005Metric
C14: 1uF; C_0603_1608Metric
D1: 1N5819WS; D_SOD-323
D2, D3, D4: D_TVS_Small_Filled; D_0805_2012Metric
D5, D6: PWRLED; LED_0603_1608Metric
J1, J2, J3: Conn_01x08_Socket; PinSocket_1x08_P2.54mm_Vertical
J4: Micro_SD_Card_Det2; microSD_HC_Hirose_DM3AT-SF-PEJM5
J5: USB_C_Receptacle_USB2.0_16P; USB_C_Receptacle_GCT_USB4085
J8: En_A; TestPoint_Pad_1.5x1.5mm
J9: En_B; TestPoint_Pad_1.5x1.5mm
Q1: MMBT2222A; SOT-23W_Handsoldering
R1, R2: 5k1; R_1206_3216Metric
R3, R6: 75; R_1206_3216Metric
R4, R5, R7, R8, R9, R10, R12, R13: 10k; R_1206_3216Metric
U1: ESP32-S3-WROOM-1
U2: AMS1117-3.3; SOT-223-3_TabPin2
U3: AMS1117-5.0; SOT-223-3_TabPin2

Connections:
BZR: BZ1.1 (+), U1.18 (IO10)
CHIP_PU: C7.1, C14.1, J9.1, R7.2, U1.3 (EN)
DATA0: J3.8, U1.4 (IO4)
DATA1: J3.7, U1.5 (IO5)
DATA2: J3.6, U1.6 (IO6)
DATA3: J3.5, U1.39 (IO1)
DATA4: J3.4, U1.38 (IO2)
DATA5: J3.3, U1.37 (TXD0)
DATA6: J3.2, U1.36 (RXD0)
DATA7: J3.1, U1.35 (IO42)
DATA8: J2.1, U1.7 (IO7)
DATA9: J2.2, U1.8 (IO15)
DATA10: J2.3, U1.9 (IO16)
DATA11: J2.4, U1.10 (IO17)
DATA12: J2.5, U1.11 (IO18)
DATA13: J2.6, U1.12 (IO8)
DATA14: J2.7, U1.15 (IO3)
DATA15: J2.8, U1.16 (IO46)
ESP_3V3: C1.1, C4.1, C5.1, C12.1, C13.1, C15.1, C16.1, D1.1 (K), J4.4 (VDD), R3.1, R4.1, R5.1, R7.1, R8.1, R9.1, R10.1, R12.1, R13.1, U1.2 (3V3), U2.2 (VO)
GPIO0: BOOT1.2, C6.1, R4.2, U1.27 (IO0)
HATS_ENABLE: Q1.1 (B), U1.20 (IO12)
I0: J1.2, U1.26 (IO45)
I1: J1.3, U1.25 (IO48)
I2: J1.4, U1.24 (IO47)
I3: J1.5, U1.23 (IO21)
I4: J1.6, U1.22 (IO14)
LIPO GND: -1.1, BOOT1.1, BZ1.2 (-), C1.2, C2.2, C3.2, C4.2, C5.2, C6.2, C7.2, C8.2, C9.2, C10.2, C11.2, C12.2, C13.2, C14.2, C15.2, C16.2, D2.2 (A2), D3.2 (A2), D4.2 (A2), D5.1 (K), D6.1 (K), J1.1, J4.6 (VSS), J4.11 (SHIELD), J5.A1 (GND), J5.A12 (GND), J5.B1 (GND), J5.B12 (GND), J5.S1 (SHIELD), R1.2, R2.2, U1.1 (GND), U1.40 (GND), U1.41 (GND), U2.1 (GND), U3.1 (GND)
LIPO PWR: +1.1, C2.1, C3.1, C8.1, C9.1, U2.3 (VI), U3.3 (VI)
unnamed: D1.2 (A), D2.1 (A1), J5.A4 (VBUS), J5.A9 (VBUS), J5.B4 (VBUS), J5.B9 (VBUS)
unnamed: D5.2 (A), R3.2
unnamed: D6.2 (A), R6.2
unnamed: J1.8, Q1.2 (E)
unnamed: J5.A5 (CC1), R2.1
unnamed: J5.B5 (CC2), R1.1
unnamed: J8.1, R5.2
SD_CLK: J4.5 (CLK), U1.32 (IO39)
SD_CMD: J4.3 (CMD), R10.2, U1.30 (IO37)
SD_DAT0: J4.7 (DAT0), R12.2, U1.33 (IO40)
SD_DAT1: J4.8 (DAT1), R13.2, U1.34 (IO41)
SD_DAT2: J4.1 (DAT2), R8.2, U1.28 (IO35)
SD_DAT3: J4.2 (DAT3/CD), R9.2, U1.29 (IO36)
SD_DET: J4.9 (DET_B), J4.10 (DET_A), U1.31 (IO38)
SELECT RETURN: J1.7, U1.21 (IO13)
USB+: D4.1 (A1), J5.A6 (D+), J5.B6 (D+), U1.14 (USB_D+)
USB-: D3.1 (A1), J5.A7 (D-), J5.B7 (D-), U1.13 (USB_D-)
VCC_5V: C10.1, C11.1, Q1.3 (C), R6.1, U3.2 (VO)

Notes on the sheet:
SD Card
Voltage Regulator 5V
ESP32-S3-WROOM-1
Voltage Regulator 3V3
Buzzer
Hat Connection Interface
Buttons
LiPo Power Input
USB-C

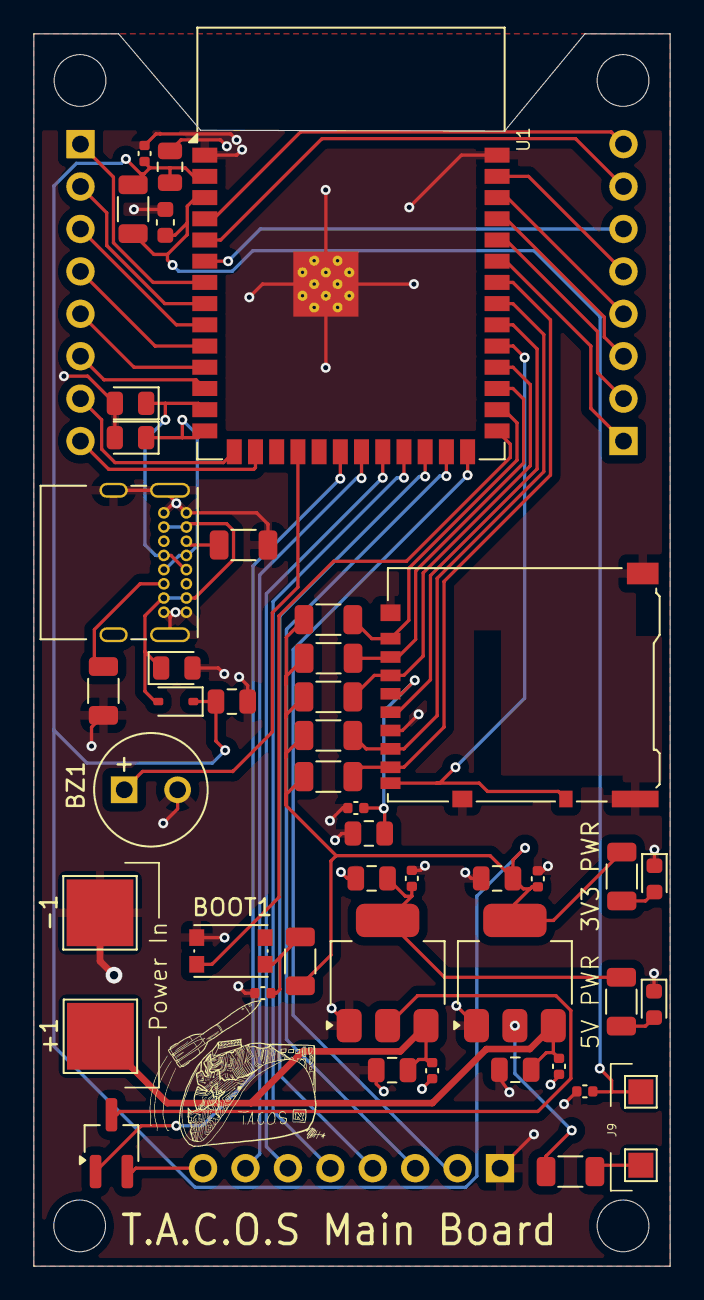
[picture p13: board hardware/Test_Boards/MainBoard 1layer/MainBoard.kicad_pcb from above]

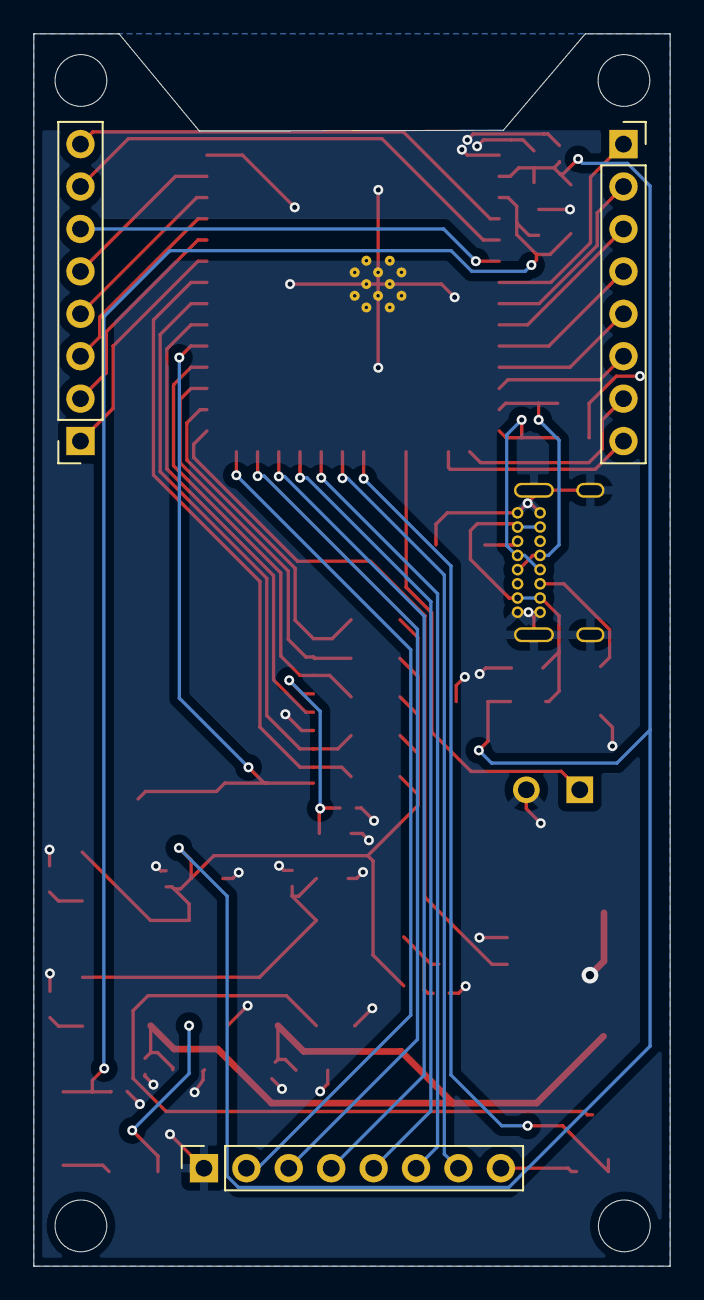
[picture p14: board hardware/Test_Boards/MainBoard 1layer/MainBoard.kicad_pcb from below]

Board: 2 copper layers, 38.1 x 73.8 mm, 49 parts (3 on the bottom side), 46 nets.
