UNR-Aerospace-Club/T.A.C.O.S/hardware/Test_Boards/BlankHat/BlankHat.kicad_pcb

## KiCad design hardware/Test_Boards/BlankHat/BlankHat.kicad_pcb (2025-09-18)

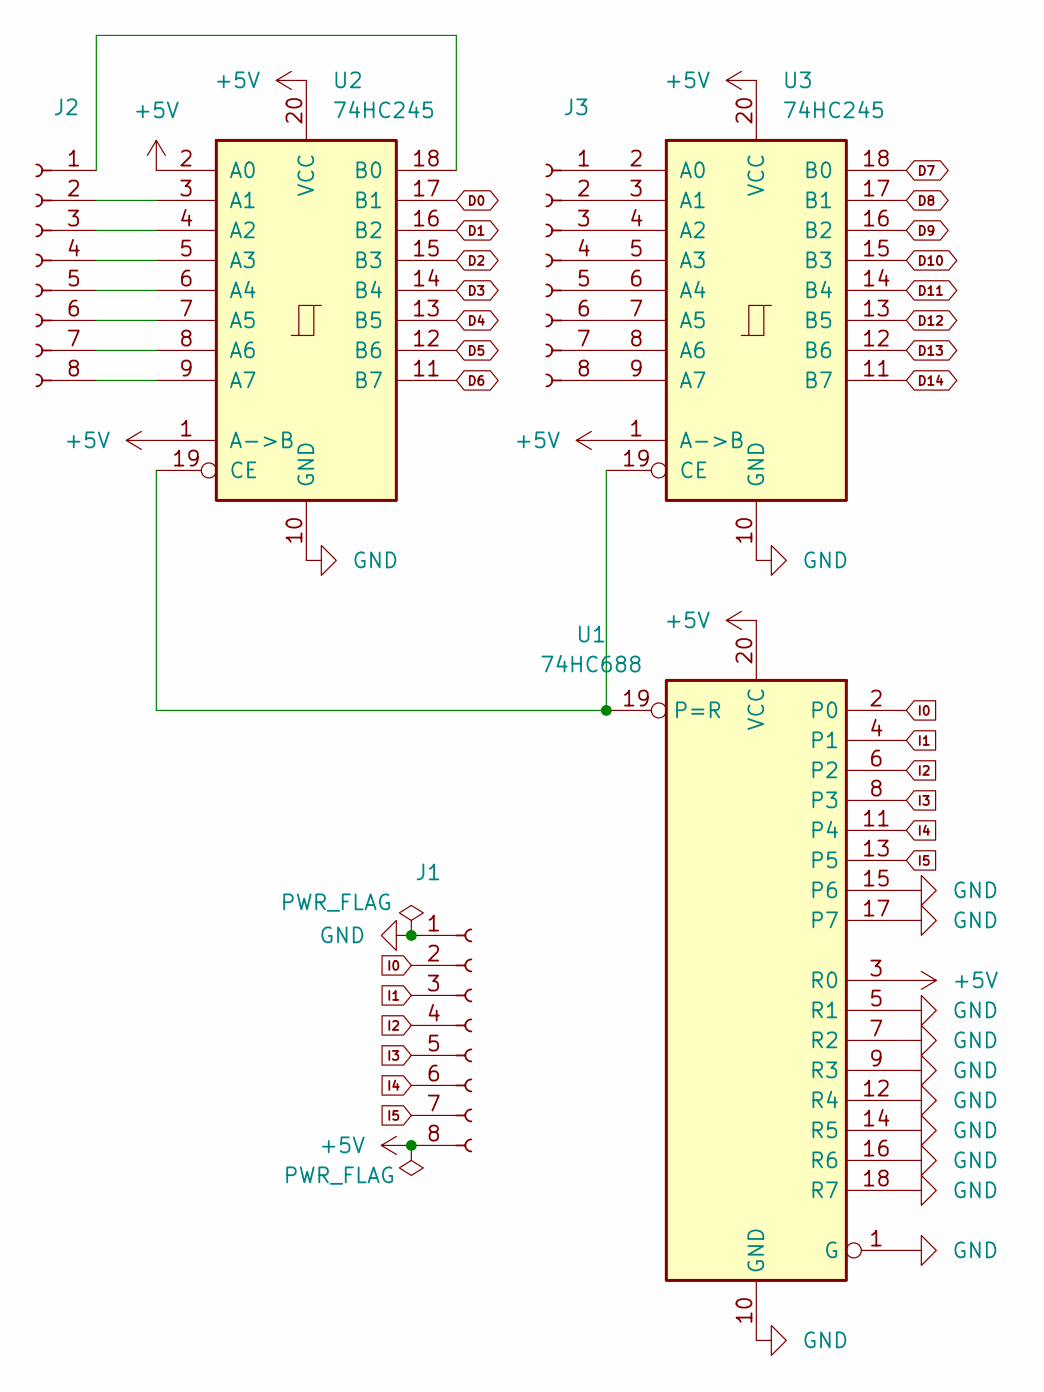
[picture p15: schematic BlankHat.kicad_sch, T.A.C.O.S]

Parts:
J1, J2, J3: Conn_01x08_Socket; PinSocket_1x08_P2.54mm_Vertical
U1: 74HC688; DIP-20_W7.62mm
U2, U3: 74HC245; DIP-20_W7.62mm

Connections:
+5V: J1.8, U1.3 (R0), U1.20 (VCC), U2.1 (A->B), U2.2 (A0), U2.20 (VCC), U3.1 (A->B), U3.20 (VCC)
D0: U2.17 (B1)
D1: U2.16 (B2)
D2: U2.15 (B3)
D3: U2.14 (B4)
D4: U2.13 (B5)
D5: U2.12 (B6)
D6: U2.11 (B7)
D7: U3.18 (B0)
D8: U3.17 (B1)
D9: U3.16 (B2)
D10: U3.15 (B3)
D11: U3.14 (B4)
D12: U3.13 (B5)
D13: U3.12 (B6)
D14: U3.11 (B7)
GND: J1.1, U1.1 (G), U1.5 (R1), U1.7 (R2), U1.9 (R3), U1.10 (GND), U1.12 (R4), U1.14 (R5), U1.15 (P6), U1.16 (R6), U1.17 (P7), U1.18 (R7), U2.10 (GND), U3.10 (GND)
I0: J1.2, U1.2 (P0)
I1: J1.3, U1.4 (P1)
I2: J1.4, U1.6 (P2)
I3: J1.5, U1.8 (P3)
I4: J1.6, U1.11 (P4)
I5: J1.7, U1.13 (P5)
unnamed: J2.1, U2.18 (B0)
unnamed: J2.2, U2.3 (A1)
unnamed: J2.3, U2.4 (A2)
unnamed: J2.4, U2.5 (A3)
unnamed: J2.5, U2.6 (A4)
unnamed: J2.6, U2.7 (A5)
unnamed: J2.7, U2.8 (A6)
unnamed: J2.8, U2.9 (A7)
unnamed: J3.1, U3.2 (A0)
unnamed: J3.2, U3.3 (A1)
unnamed: J3.3, U3.4 (A2)
unnamed: J3.4, U3.5 (A3)
unnamed: J3.5, U3.6 (A4)
unnamed: J3.6, U3.7 (A5)
unnamed: J3.7, U3.8 (A6)
unnamed: J3.8, U3.9 (A7)
unnamed: U1.19 (P=R), U2.19 (CE), U3.19 (CE)

Board: 2 copper layers, 6 parts (0 on the bottom side), 25 nets, no tracks yet.
