UNR-Aerospace-Club/T.A.C.O.S/hardware/Test_Boards/DummyHat/DummyHat.kicad_pcb

## KiCad design hardware/Test_Boards/DummyHat/DummyHat.kicad_pcb (2025-09-22)

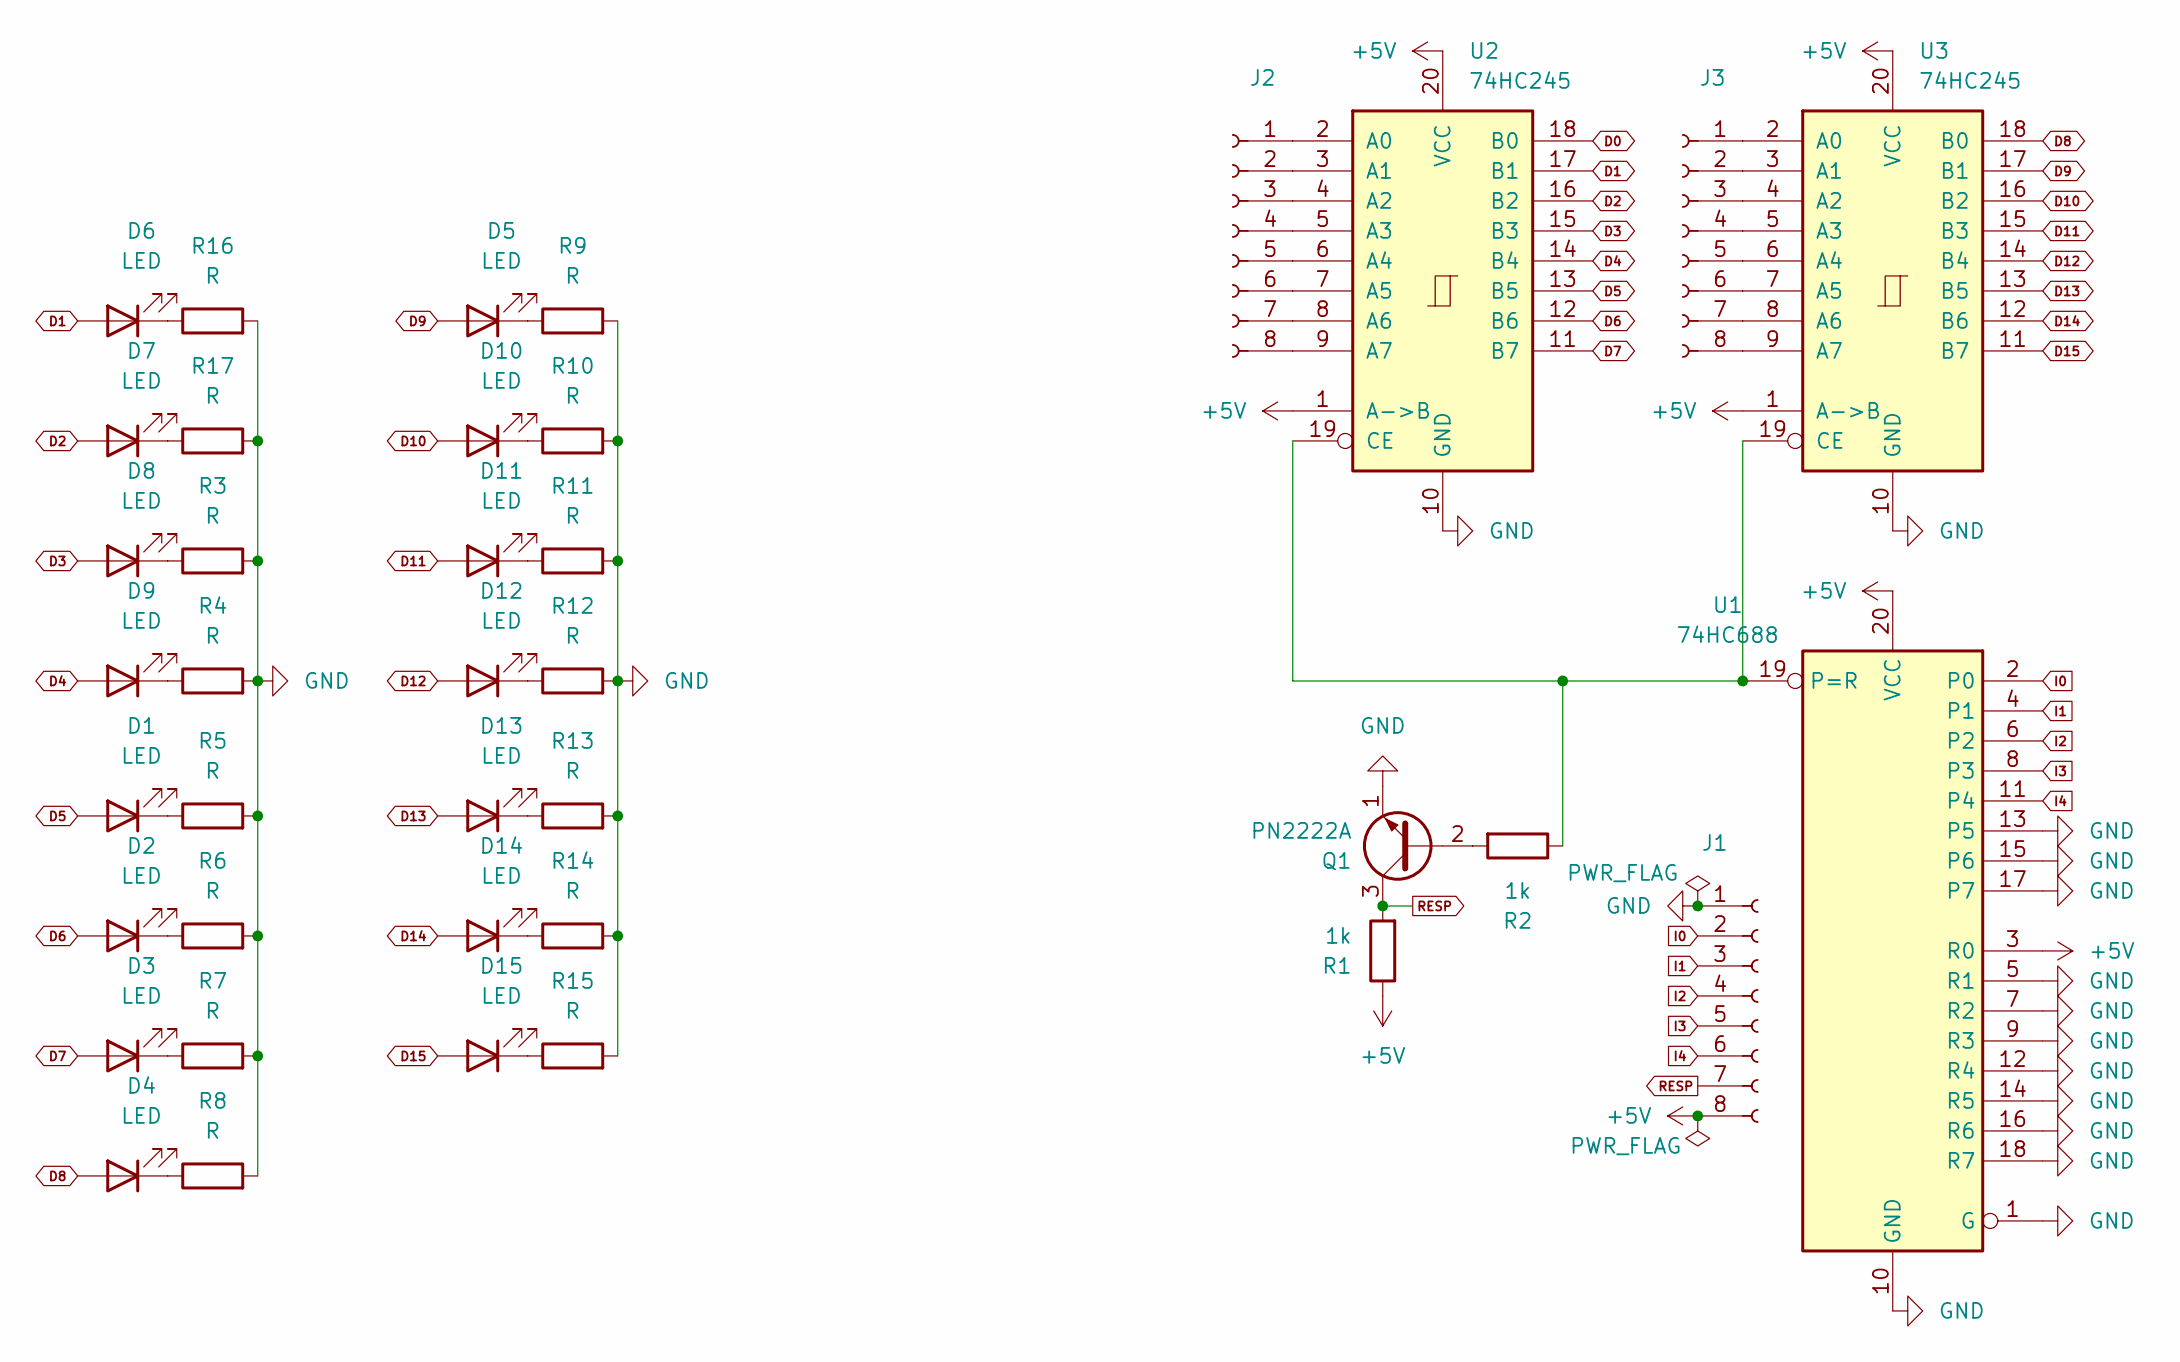
[picture p16: schematic DummyHat.kicad_sch]

Parts:
D1, D2, D3, D4, D5, D6, D7, D8, D9, D10, D11, D12, D13, D14, D15: LED; LED_D5.0mm
J1, J2, J3: Conn_01x08_Socket; PinSocket_1x08_P2.54mm_Vertical
Q1: PN2222A; TO-92_Inline
R1, R2: 1k; R_Axial_DIN0207_L6.3mm_D2.5mm_P10.16mm_Horizontal
R3, R4, R5, R6, R7, R8, R9, R10, R11, R12, R13, R14, R15, R16, R17: R; R_Axial_DIN0207_L6.3mm_D2.5mm_P10.16mm_Horizontal
U1: 74HC688; DIP-20_W7.62mm
U2, U3: 74HC245; DIP-20_W7.62mm

Connections:
+5V: J1.8, R1.1, U1.3 (R0), U1.20 (VCC), U2.1 (A->B), U2.20 (VCC), U3.1 (A->B), U3.20 (VCC)
D0: U2.18 (B0)
D1: D6.2 (A), U2.17 (B1)
D2: D7.2 (A), U2.16 (B2)
D3: D8.2 (A), U2.15 (B3)
D4: D9.2 (A), U2.14 (B4)
D5: D1.2 (A), U2.13 (B5)
D6: D2.2 (A), U2.12 (B6)
D7: D3.2 (A), U2.11 (B7)
D8: D4.2 (A), U3.18 (B0)
D9: D5.2 (A), U3.17 (B1)
D10: D10.2 (A), U3.16 (B2)
D11: D11.2 (A), U3.15 (B3)
D12: D12.2 (A), U3.14 (B4)
D13: D13.2 (A), U3.13 (B5)
D14: D14.2 (A), U3.12 (B6)
D15: D15.2 (A), U3.11 (B7)
GND: J1.1, Q1.1 (E), R3.2, R4.2, R5.2, R6.2, R7.2, R8.2, R9.2, R10.2, R11.2, R12.2, R13.2, R14.2, R15.2, R16.2, R17.2, U1.1 (G), U1.5 (R1), U1.7 (R2), U1.9 (R3), U1.10 (GND), U1.12 (R4), U1.13 (P5), U1.14 (R5), U1.15 (P6), U1.16 (R6), U1.17 (P7), U1.18 (R7), U2.10 (GND), U3.10 (GND)
I0: J1.2, U1.2 (P0)
I1: J1.3, U1.4 (P1)
I2: J1.4, U1.6 (P2)
I3: J1.5, U1.8 (P3)
I4: J1.6, U1.11 (P4)
unnamed: D1.1 (K), R5.1
unnamed: D2.1 (K), R6.1
unnamed: D3.1 (K), R7.1
unnamed: D4.1 (K), R8.1
unnamed: D5.1 (K), R9.1
unnamed: D6.1 (K), R16.1
unnamed: D7.1 (K), R17.1
unnamed: D8.1 (K), R3.1
unnamed: D9.1 (K), R4.1
unnamed: D10.1 (K), R10.1
unnamed: D11.1 (K), R11.1
unnamed: D12.1 (K), R12.1
unnamed: D13.1 (K), R13.1
unnamed: D14.1 (K), R14.1
unnamed: D15.1 (K), R15.1
unnamed: J2.1, U2.2 (A0)
unnamed: J2.2, U2.3 (A1)
unnamed: J2.3, U2.4 (A2)
unnamed: J2.4, U2.5 (A3)
unnamed: J2.5, U2.6 (A4)
unnamed: J2.6, U2.7 (A5)
unnamed: J2.7, U2.8 (A6)
unnamed: J2.8, U2.9 (A7)
unnamed: J3.1, U3.2 (A0)
unnamed: J3.2, U3.3 (A1)
unnamed: J3.3, U3.4 (A2)
unnamed: J3.4, U3.5 (A3)
unnamed: J3.5, U3.6 (A4)
unnamed: J3.6, U3.7 (A5)
unnamed: J3.7, U3.8 (A6)
unnamed: J3.8, U3.9 (A7)
unnamed: Q1.2 (B), R2.2
unnamed: R2.1, U1.19 (P=R), U2.19 (CE), U3.19 (CE)
RESP: J1.7, Q1.3 (C), R1.2

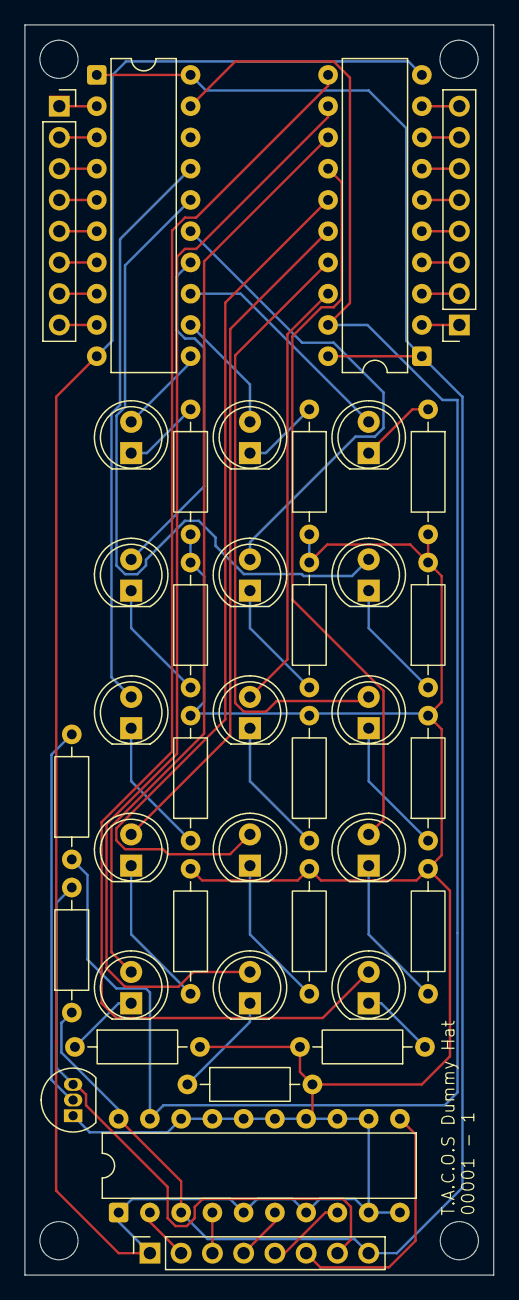
[picture p17: board hardware/Test_Boards/DummyHat/DummyHat.kicad_pcb from above]

Board: 2 copper layers, 38.1 x 101.6 mm, 39 parts (0 on the bottom side), 56 nets.
