UNR-Aerospace-Club/T.A.C.O.S/hardware/Test_Boards/TacosDevBoard/TacosDevBoard.kicad_pcb

## KiCad design hardware/Test_Boards/TacosDevBoard/TacosDevBoard.kicad_pcb (2025-09-22)

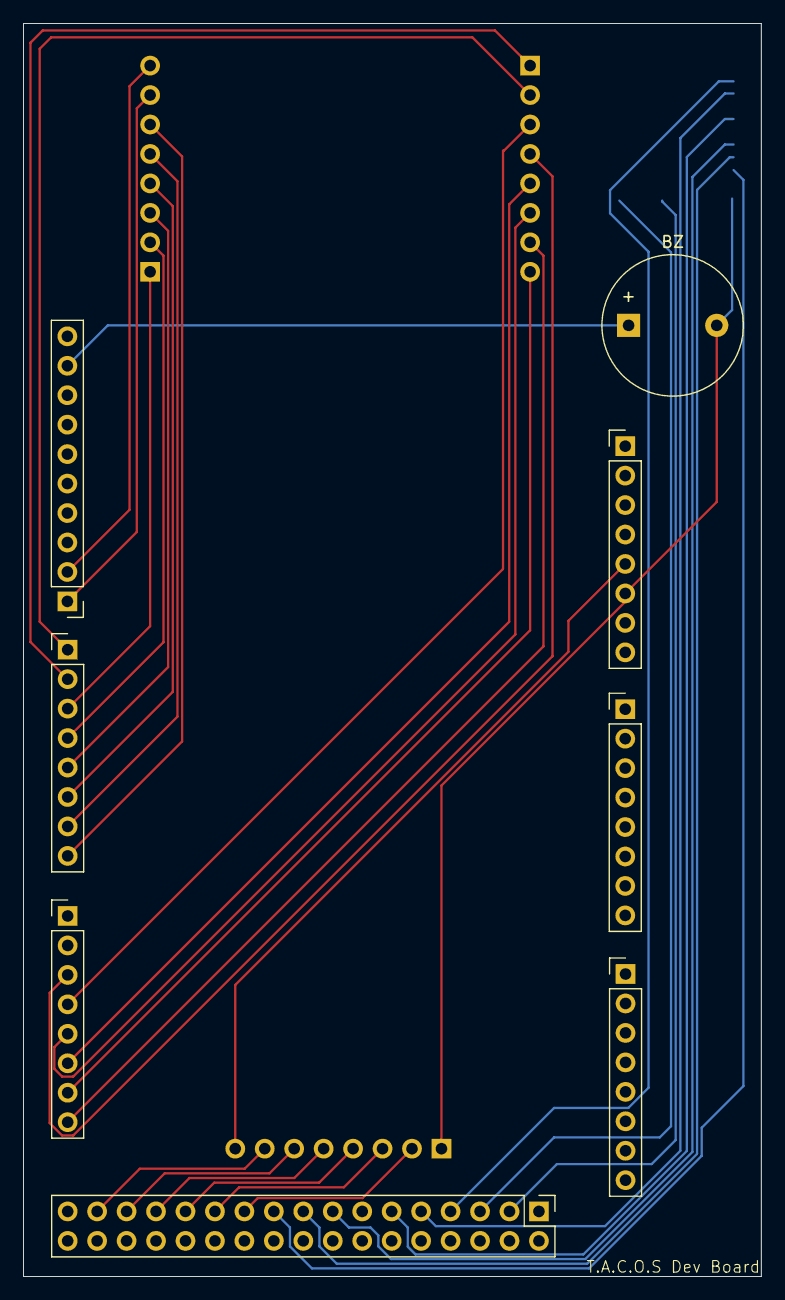
[picture p18: board TacosDevBoard.kicad_pcb from above]

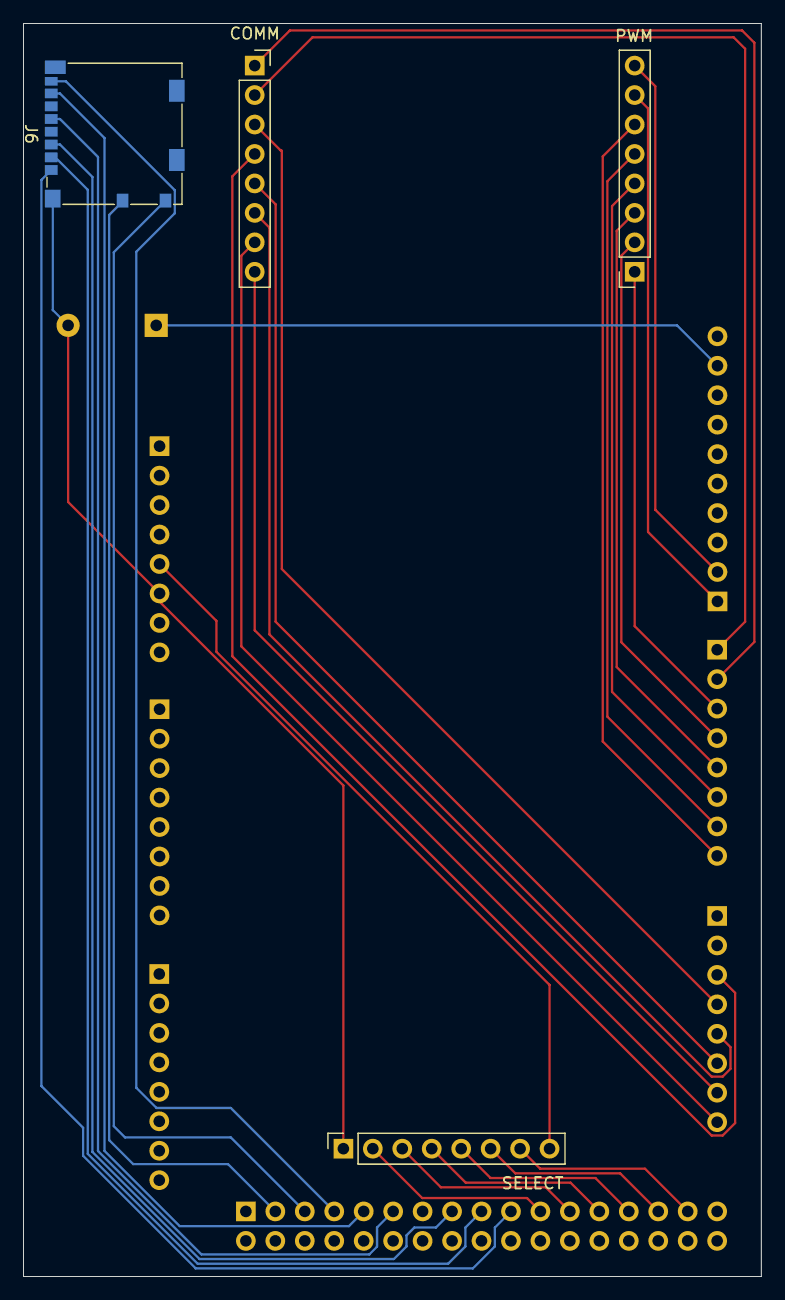
[picture p19: board TacosDevBoard.kicad_pcb from below]

Board: 2 copper layers, 63.6 x 108.1 mm, 12 parts (4 on the bottom side), 35 nets.

Parts:
BZ: Buzzer; Buzzer_12x9.5RM7.6
COMM: Conn_01x08_Socket; PinSocket_1x08_P2.54mm_Vertical
J1, J2, J3, J4, J5: Conn_01x08_Socket; PinHeader_1x08_P2.54mm_Vertical
J6: Micro_SD_Card_Det2; microSD_HC_Molex_104031-0811
J8: Conn_02x17_Odd_Even; PinHeader_2x17_P2.54mm_Vertical
J9: Conn_01x10_Pin; PinHeader_1x10_P2.54mm_Vertical
PWM: Conn_01x08_Socket; PinSocket_1x08_P2.54mm_Vertical
SELECT: Conn_01x08_Socket; PinSocket_1x08_P2.54mm_Vertical

Connections:
+5V: J3.5, J8.1, J8.2, SELECT.8
D22: J8.31, SELECT.7
D24: J8.29, SELECT.6
D26: J8.27, SELECT.5
D28: J8.25, SELECT.4
D30: J8.23, SELECT.3
D32: J8.21, SELECT.2
D52: BZ.1 (+), J9.9
GND: BZ.2 (-), J3.6, J6.11 (SHIELD), J8.33, J8.34, SELECT.1
RX0: COMM.2, J5.1
RX1: COMM.4, J4.3
RX2: COMM.6, J4.5
RX3: COMM.8, J4.7
SD_CLK: J6.5 (CLK), J8.11
SD_CMD: J6.3 (CMD), J8.15
SD_DAT0: J6.7 (DAT0), J8.9
SD_DAT1: J6.8 (DAT1), J8.7
SD_DAT2: J6.1 (DAT2), J8.19
SD_DAT3/CD: J6.2 (DAT3/CD), J8.17
SD_DET_A: J6.10 (DET_A), J8.5
SD_DET_B: J6.9 (DET_B), J8.3
TX0: COMM.1, J5.2
TX1: COMM.3, J4.4
TX2: COMM.5, J4.6
TX3: COMM.7, J4.8
VDD: J3.4, J6.4 (VDD)
VSS: J3.7, J6.6 (VSS)
~D2: J5.3, PWM.1
~D3: J5.4, PWM.2
~D4: J5.5, PWM.3
~D5: J5.6, PWM.4
~D6: J5.7, PWM.5
~D7: J5.8, PWM.6
~D8: J9.1, PWM.7
~D9: J9.2, PWM.8
