UNR-Aerospace-Club/T.A.C.O.S/(commit log)

2025-09-15 Baseline layout for T.A.C.O.S dev board
    [TacosDevBoard.kicad_pcb, TacosDevBoard.kicad_sch]
2025-09-15 Add buzzer to Dev Board
    [TacosDevBoard.kicad_pcb, TacosDevBoard.kicad_sch]
2025-09-15 Ignore lock files for kicad
2025-09-16 started working on dummy board - not finished
    [DummyHat.kicad_pcb, DummyHat.kicad_sch]
2025-09-16 Add orthogonal dimensions to dev board
    [TacosDevBoard.kicad_pcb]
2025-09-16 Finish First Dummy Hat Design
    [DummyHat.kicad_pcb, DummyHat.kicad_sch]
2025-09-17 Update dummy board schematic
    Update dummy board schematic to use octal tranciever chip. Issues. Data pins are now one way and do not support analog.
    [DummyHat.kicad_sch]
2025-09-17 Finish dev board. Limitations still apply.
    [DummyHat.kicad_pcb, DummyHat.kicad_sch]
2025-09-17 finished mega pcb
    [TacosDevBoard.kicad_pcb, TacosDevBoard.kicad_sch]
2025-09-18 finished dev board
    [TacosDevBoard.kicad_pcb, TacosDevBoard.kicad_sch]
2025-09-18 added blank hat
    [ArduMega.kicad_pcb, ArduMega.kicad_sch, BlankHat.kicad_pcb, BlankHat.kicad_sch]
2025-09-18 applied noconnects to unused dev board pins
    [TacosDevBoard.kicad_pcb, TacosDevBoard.kicad_sch]
2025-09-18 started adding SD card
    [TacosDevBoard.kicad_pcb, TacosDevBoard.kicad_sch]
2025-09-19 added sd card to dev board
    [TacosDevBoard.kicad_pcb, TacosDevBoard.kicad_sch]
2025-09-19 added power for sd
    [TacosDevBoard.kicad_pcb]
2025-09-19 add not gate to dummy board for 16 data pins
    [DummyHat.kicad_pcb, DummyHat.kicad_sch]
2025-09-21 finished dev board rewire
    [TacosDevBoard.kicad_pcb, TacosDevBoard.kicad_sch]
2025-09-21 cleaned up silks
    [TacosDevBoard.kicad_pcb]
2025-09-21 cleaned up silkslides
    [DummyHat.kicad_pcb]
2025-09-22 started working on hat detection and selection
    [DummyHat-B_Cu.gbr, DummyHat-B_Mask.gbr, DummyHat-B_Paste.gbr, DummyHat-B_Silkscreen.gbr, DummyHat-Edge_Cuts.gbr, DummyHat-F_Cu.gbr, DummyHat-F_Mask.gbr, DummyHat-F_Paste.gbr]
2025-09-26 started working on main board
    [MainBoard.kicad_pcb, MainBoard.kicad_sch]
2025-09-26 added more stuff to main board
    [MainBoard.kicad_pcb, MainBoard.kicad_sch]
2025-09-26 finished usb and voltage regulator
    [MainBoard.kicad_pcb, MainBoard.kicad_sch]
2025-09-27 added buttons to main board
    [MainBoard.kicad_sch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]
2025-09-29 added another voltage regulator
    [MainBoard.kicad_sch]
2025-09-29 added lots of things to main board
    [MainBoard.kicad_pcb, MainBoard.kicad_sch]
2025-09-30 more main board stuff
    [MainBoard.kicad_pcb, MainBoard.kicad_sch]
2025-09-30 finished main board
    [MainBoard.kicad_pcb, MainBoard.kicad_sch]
2025-09-30 added power from usb to main board
    [MainBoard.kicad_pcb, MainBoard.kicad_sch]
2025-09-30 added no connects to our two empty pins on the esp32
    [MainBoard.kicad_sch]
2025-10-01 started working on blank smd hat:
    [ArduMega.kicad_pcb, ArduMega.kicad_sch, BlankHat.kicad_pcb, BlankHat.kicad_sch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]
2025-10-01 tacos logo and font change
    [MainBoard.kicad_pcb]
2025-10-01 added power flag to ground
    [MainBoard.kicad_pcb, MainBoard.kicad_sch]
2025-10-02 designing new main board
    [BlankHat.kicad_pcb, BlankHat.kicad_sch, DummyHat.kicad_pcb, DummyHat.kicad_sch, MainBoard.kicad_pcb, MainBoard.kicad_sch]
2025-10-02 main boards almost done:
    [MainBoard.kicad_pcb, MainBoard.kicad_sch, main.kicad_sch]
2025-10-03 started wiring main boards
    [MainBoard.kicad_pcb, MainBoard.kicad_sch, peripherals.kicad_sch]
2025-10-03 connector footprints
2025-10-03 fix margin on connector footprint
2025-10-03 wide board lel
    [MainBoard.kicad_pcb, MainBoard.kicad_sch]
2025-10-03 main board stuff
    [MainBoard.kicad_pcb]
2025-10-04 start arranging componnets for rack layout
    [MainBoard.kicad_pcb]
2025-10-06 started final traces
    [MainBoard.kicad_pcb, MainBoard.kicad_sch]
2025-10-06 start on rack model
    [Rack.FCStd]
2025-10-06 Revert "merge? i might have messed it up"
    This reverts commit 9783b900dc87fa86d5773213ec3461e06766d3d4, reversing
    changes made to c60a9f34725409086c7bd1e4ee39c0fff9320fd7.
    [MainBoard.kicad_sch]
2025-10-06 finished 1x1 main board
    [MainBoard.kicad_pcb, MainBoard.kicad_sch, peripherals.kicad_sch]
2025-10-06 replaced files with backup - were broken
    [MainBoard.kicad_pcb, MainBoard.kicad_sch]
2025-10-06 made boards actually square lmao
    [MainBoard.kicad_pcb]
2025-10-06 finished main board w/ ground and power planes
    [MainBoard.kicad_pcb, MainBoard.kicad_sch]
2025-10-07 remove freecad backups and clean up usb c port
    [Rack.FCStd]
2025-10-07 added emulation board
2025-10-10 added voltage switcher - still needs to be routed
    [EmulationBoard.kicad_pcb, EmulationBoard.kicad_sch, MainBoard.kicad_sch, peripherals.kicad_sch]
2025-10-12 added USB power switching
    [MainBoard.kicad_pcb, MainBoard.kicad_sch]
2025-10-13 changing stuff to make it pin based, not bool based
2025-10-27 started adding subsystems for the emulation hat
    [EmulationBoard.kicad_pcb, EmulationBoard.kicad_sch]
2025-10-29 more emulation hat stuff
    [EmulationBoard.kicad_pcb, EmulationBoard.kicad_sch, nano.kicad_pcb, nano.kicad_sch]
2025-11-14 correct connector placement
    [EmulationBoard.kicad_pcb, EmulationBoard.kicad_sch]
2025-11-14 emulation hat and stuff
    [EmulationBoard.kicad_pcb]
2025-11-14 start on rocket hat
    [RocketHat.kicad_pcb, RocketHat.kicad_sch]
2025-11-16 Rocket hat sensor libraries
    [RocketHat.kicad_pcb, RocketHat.kicad_sch]
2025-11-16 Rocket Hat schematic done
    [RocketHat.kicad_pcb, RocketHat.kicad_sch]
2025-11-17 rocket hat footprints done
    [RocketHat.kicad_pcb, RocketHat.kicad_sch]
2025-11-17 rocket hat connector labels
    [RocketHat.kicad_pcb, RocketHat.kicad_sch]
2025-11-17 added power passthrough via data pins WTFFFF
    [MainBoard.kicad_pcb, MainBoard.kicad_sch]
2025-11-17 start routing
    [RocketHat.kicad_pcb]
2025-11-18 Work more on traces for rocket hat and add dipswitch
    [RocketHat.kicad_pcb, RocketHat.kicad_sch]
2025-11-19 keep routing rocket hat
    [RocketHat.kicad_pcb]
2025-11-19 rocker hat work
    [RocketHat.kicad_pcb]
2025-11-19 fixed main hat
    [MainBoard.kicad_pcb, MainBoard.kicad_sch]
2025-11-20 rocket hat finished routing 4 layer
    [RocketHat.kicad_pcb]
2025-11-20 more main board polish
    [MainBoard.kicad_pcb]
2025-11-20 rocket hat done
    [RocketHat.kicad_pcb, RocketHat.kicad_sch]
2025-11-20 remove rocket hat c5 silkscreen
    [RocketHat.kicad_pcb]
2025-11-23 generated assembly files
    [BOM-MainBoard.csv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]
2025-11-23 sanity checked, ready for production
    [BOM_test_mainboard.csv, MainBoard.kicad_pcb, MainBoard.kicad_sch, RocketHat.kicad_pcb, RocketHat.kicad_sch]
2025-11-23 made the blank hat with correct footprint
    [BlankHat.kicad_pcb, BlankHat.kicad_sch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]
2025-11-24 changed voltage selector to actually work
    [DummyHat.kicad_pcb, DummyHat.kicad_sch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]
